Davdan11/Davdan11/vtol-quadplane/docs/essais_virtuels_mini.md

# Essais virtuels — Huard Mini

Généré par `calc/essais_virtuels.py`. Ce sont des calculs d'ingénieur classiques de pré-dimensionnement, faits sur les cotes réelles du modèle. Ils disent si la conception tient, avec quelle marge, et où sont les points faibles. Ils ne remplacent pas les essais au sol (test de charge de l'aile, voir plus bas) ni les premiers vols prudents.

Masse au décollage 2.21 kg, surface alaire 0.192 m², charge alaire 11.5 kg/m², décrochage 43 km/h, vitesse max réglée dans ArduPilot 90 km/h, vitesse de calcul en piqué 112 km/h.

## Résumé

✅ longeron principal Ø10 à 5.8 g (charge extrême) : 260 MPa pour 500 admissibles
✅ longeron extérieur Ø6 : 140 MPa pour 500
✅ aile en VTOL plein gaz : 104 MPa dans le longeron principal
✅ poutres en VTOL plein gaz : 36 MPa, flèche 0.4 mm
✅ atterrissage dur à 2 m/s : 196 MPa dans les poutres (21 g d'impact si les pattes s'écrasent de 10 mm)
✅ peau sous la pression de l'air : 3.4 MPa au pire panneau pour 25 MPa (flèche 0.46 mm)
✅ peau d'extrados comprimée par la flexion : elle n'ondule pas avant 7.1 g (charge limite 3.9 g)
✅ torsion à 112 km/h : peau 1.21 MPa, goupille 3 MPa, appui de la goupille dans le fuselage 1.9 MPa
✅ relais des longerons (recouvrement de 80 mm) : colle 0.16 MPa, appui dans le fourreau 0.7 MPa
✅ inversion des ailerons vers 903 km/h, divergence vers 498 km/h (il faut plus de 1,2 × 112 = 135 km/h)
✅ marge statique 14% (bien entre 5 et 20 %) : point neutre à 67 mm, centre de gravité à 45 mm
✅ volume d'empennage horizontal 0.41 (habituel 0,35 à 0,6)
✅ volume d'empennage vertical 0.024 (habituel 0,02 à 0,04)
✅ braquage de profondeur pour équilibrer : au plus 8° sur ±25° disponibles
✅ servos (±20° à 84 km/h, ±7° à 112 km/h) : aileron 0.19 kg·cm, profondeur 0.11 kg·cm, pour 2.2 kg·cm (8% ; à garder sous 50 %)
✅ résonance des poutres à 88 Hz (5300 tr/min) ; moteurs ≈ 10437 tr/min en stationnaire : on ne fait que la traverser en montant les gaz

✅ tient avec marge · ⚠️ à connaître (pas dangereux) · ❌ à corriger

## 1. Pression de l'air sur l'aile

Méthode des panneaux sur le profil NACA 4412 (Cp = 1 − (V/V∞)²). Dépression = Cp négatif, sur le dessus. Image : `docs/images/pression_aile_mini.png`.

| Cas | Vitesse | CL | Incidence du profil | Dépression max (bord d'attaque) |
|---|---:|---:|---:|---:|
| Croisière 72 km/h (1 g) | 72 km/h | 0.46 | -0.3° | 185 Pa (18.5 g/cm²) |
| Ressource à 84 km/h (3.9 g, portance max) | 84 km/h | 1.30 | 7.2° | 994 Pa (99.4 g/cm²) |
| Ressource à 112 km/h (3.9 g) | 112 km/h | 0.73 | 2.1° | 601 Pa (60.1 g/cm²) |

Peau de 0.6 mm entre deux âmes : le pire panneau fait 67 mm de large (Ressource à 112 km/h (3.9 g), segment 413–600 mm). Sous 550 Pa il fléchit de 0.46 mm et travaille à 3.40 MPa, pour environ 25 MPa de résistance : la peau ne se creuse pas visiblement.

## 2. Charges de vol

- Manœuvre : 3.8 g (catégorie normale). Rafale verticale de 7.6 m/s à 72 km/h : **3.9 g** (formule de Pratt ; un petit avion léger est très secoué par les rafales).
- Charge limite retenue **3.9 g**, charge extrême (1.5 ×) **5.8 g**.
- Vitesse de manœuvre (décroche avant de casser) : 84 km/h.

## 3. Flexion de l'aile

Répartition de portance de Schrenk. Image : `docs/images/flexion_aile_mini.png`.

| Endroit | Moment à charge extrême | Tube | Contrainte | Admissible |
|---|---:|---|---:|---:|
| Emplanture (y = 40 mm) | 15.0 N·m | Ø10 × 1 mm | 260 MPa | 500 MPa |
| Fin du longeron principal (y = 360 mm) | 2.4 N·m | Ø6 × 1 mm | 140 MPa | 500 MPa |
| Emplanture en VTOL plein gaz | 6.0 N·m | Ø10 × 1 mm | 104 MPa | 500 MPa |

Flèche en bout d'aile en vol normal (1 g) : **8 mm** (longerons seuls ; la peau raidit un peu).

**La peau suit la flexion.** Collée aux longerons par les âmes, la coque imprimée porte une partie de la flexion : l'extrados est comprimé. Une peau mince et large entre deux âmes ondule (voilement) quand la compression dépasse sa limite. Ce n'est pas une rupture (les tubes portent la charge), mais à répétition la peau peut fissurer. On veut donc que ça n'arrive pas avant la charge limite.

| Segment | Diagonales | Panneau le plus large | Part de la peau dans la raideur | Compression à 1 g | Limite d'ondulation | Ondule à partir de |
|---:|---:|---:|---:|---:|---:|---:|
| 1 | 12 | 23 mm | 57% | 1.18 MPa | 8.40 MPa | **7.1 g** |
| 2 | 8 | 37 mm | 53% | 0.46 MPa | 3.88 MPa | **8.5 g** |
| 3 | 5 | 67 mm | 87% | 0.17 MPa | 1.75 MPa | **10.2 g** |

Relais entre les longerons (recouvrement de 80 mm) : le tube extérieur pousse sur son fourreau avec ≈ 60 N à charge extrême, soit 0.7 MPa d'appui sur le PLA et 0.16 MPa dans la colle époxy (elle tient 10 à 20 MPa).

## 4. Torsion, goupille, inversion d'ailerons

- Couple de torsion à l'emplanture (112 km/h, aileron braqué, × 1.5) : 2.44 N·m.
- Cisaillement dans la peau : 1.21 MPa (≈ 12 admissibles).
- Goupille Ø4 : effort 38 N, cisaillement 3 MPa, appui dans le bossage du fuselage 1.9 MPa.
- Raideur en torsion de l'aile (coque seule) : GJ ≈ 29 N·m². Les ailerons s'inverseraient vers **903 km/h** et l'aile divergerait vers **498 km/h** : loin au-dessus de ce que l'avion peut faire.

## 5. Stabilité et équilibre

- Point neutre à **67 mm** du bord d'attaque (42% de corde), centre de gravité à 45 mm : **marge statique 14%**. Un avion se pilote bien entre 5 et 15 %.
- Volume d'empennage horizontal 0.41, vertical 0.024.
- Effet du fuselage pris en compte (Raymer) ; descente du flux de l'aile sur le stab dε/dα = 0.41.

| Vol en palier | Braquage de profondeur pour équilibrer | Assiette du fuselage |
|---|---:|---:|
| 56 km/h | -2.6° | +3.0° |
| 72 km/h | +0.6° | -0.6° |
| 90 km/h | +2.4° | -2.6° |
| Ressource 3.9 g à 84 km/h | -8.2° | |

(+ = bord de fuite de la profondeur vers le bas.) La profondeur garde de la réserve sur ses ±25°. ArduPilot règle le reste tout seul (TRIM_PITCH_DEG, autotune).

## 6. Servos et débattements

Comme la norme des avions légers : plein braquage (±20°) à la vitesse de manœuvre (84 km/h), un tiers du braquage à la vitesse de piqué (112 km/h). Servo qui tourne de ±45°.

| Gouverne | Moment de charnière | Bras du guignol (trou intérieur) | Trou du palonnier pour ±20° | Couple au servo | Servo |
|---|---:|---:|---:|---:|---:|
| Aileron (chacun) | 3.8 N·cm | 16 mm | **8 mm** de l'axe | 0.19 kg·cm | 8% de 2.2 kg·cm |
| Profondeur (les deux) | 2.3 N·cm | 11 mm | **5 mm** de l'axe | 0.11 kg·cm | 5% de 2.2 kg·cm |

Régler les fins de course dans ArduPilot (SERVOx_MIN / MAX) pour ±20° de gouverne, mesurés au rapporteur. Plus de débattement n'apporte rien à cet avion et charge les servos.

## 7. Poutres, vibrations, atterrissage

- Plein gaz en stationnaire (1.2 kg par moteur, × 1.5) : 36 MPa dans la poutre, flèche 0.4 mm au moteur.
- Fréquence propre d'une poutre avec son moteur : **88 Hz** (5300 tr/min). En stationnaire les moteurs tournent vers 10437 tr/min : on ne fait que traverser la résonance en montant les gaz. Équilibrer les hélices et activer le filtre anti-vibration d'ArduPilot (INS_HNTCH_*) après le premier vol.
- Atterrissage dur à 2 m/s (4 fois la vitesse normale) : si les pattes TPU s'écrasent de 10 mm, l'impact fait 21 g, 116 N par patte, 196 MPa dans les poutres.

## Ce qu'il faut vérifier en vrai

1. **Test de charge de l'aile au sol** (le plus important) : aile montée sur le fuselage, posée à l'envers sur deux tréteaux sous le fuselage, répartir des sacs de sable sur l'intrados. 3.9 g, c'est 8.6 kg en tout, dont 60 % sur la moitié intérieure de chaque aile. Monter par paliers ; l'aile doit revenir droite. Ne pas aller jusqu'à la charge extrême.
2. **Les servos** : avec l'avion branché, pousser une gouverne au doigt : elle ne doit pas bouger, et le servo ne doit pas grogner au neutre.
3. **Le centrage** : soulever l'avion du bout des doigts sous l'aile au point de centrage (45 mm du bord d'attaque) : il doit rester à plat ou piquer très légèrement du nez.
4. **Les vibrations** : premier vol stationnaire, puis lire le log (VIBE) dans Mission Planner.

## Hypothèses

- PLA imprimé : module 3000 MPa, résistance 25 MPa, cisaillement 12 MPa (valeurs prudentes, non mesurées).
- Tubes carbone roulés : module 100 GPa, 500 MPa admissibles en flexion (les tubes du commerce tiennent 600 à 1000 MPa) ; épaisseur 1 mm.
- Servo 2.2 kg·cm à 4,8 V (fiche technique), à garder sous 50 % en continu. Moment de charnière : coefficients habituels d'une gouverne simple ; peau de gouverne étanche (ruban).
- Méthode des panneaux sans viscosité : elle surestime un peu la dépression (côté sûr).
- Poussée max d'un moteur VTOL : 1.2 kg (même valeur que le bilan).
