Davdan11/Davdan11/vtol-quadplane/cad/out/rendus/vue_cote.png

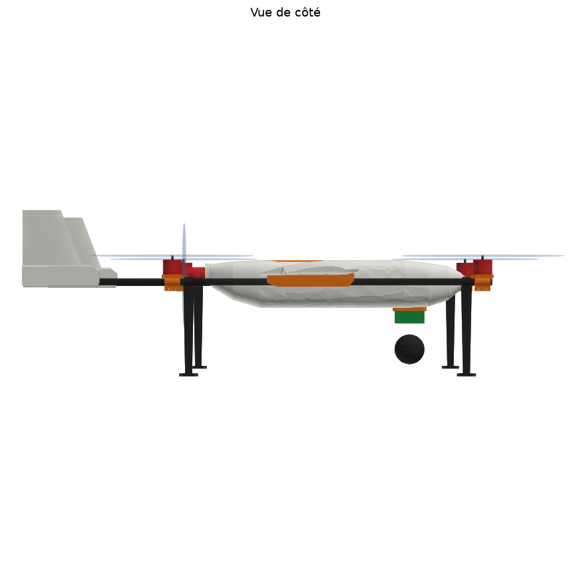
vtol-quadplane/cad/out/rendus/vue_cote.png
