Davdan11/Davdan11/vtol-quadplane/cad/out/rendus/vue_face.png

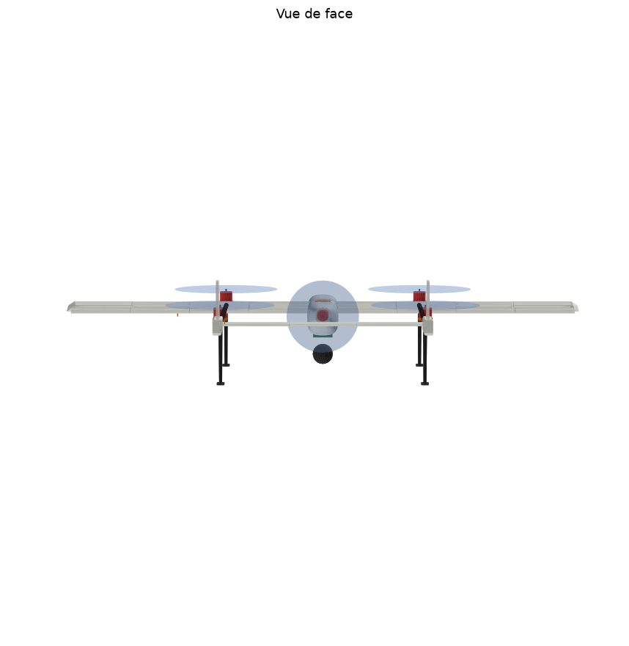
vtol-quadplane/cad/out/rendus/vue_face.png
