Davdan11/Davdan11/vtol-quadplane/cad/out_mini/rendus/vue_dessus.png

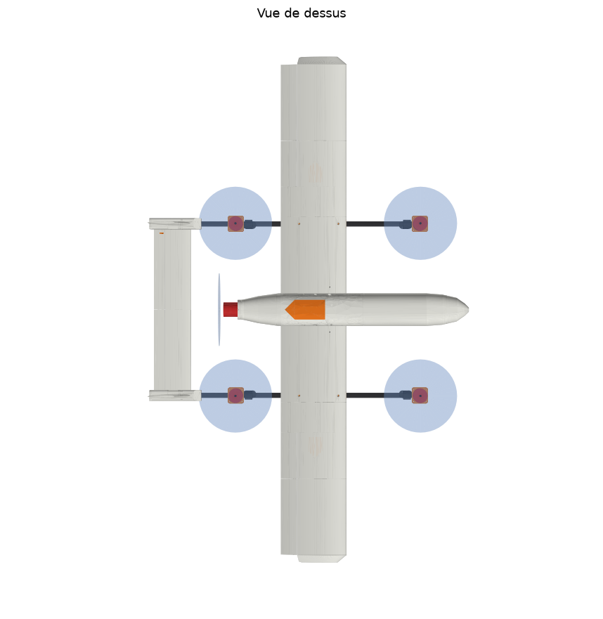
vtol-quadplane/cad/out_mini/rendus/vue_dessus.png
