Davdan11/Davdan11/vtol-quadplane/docs/images/batterie_dfr.png

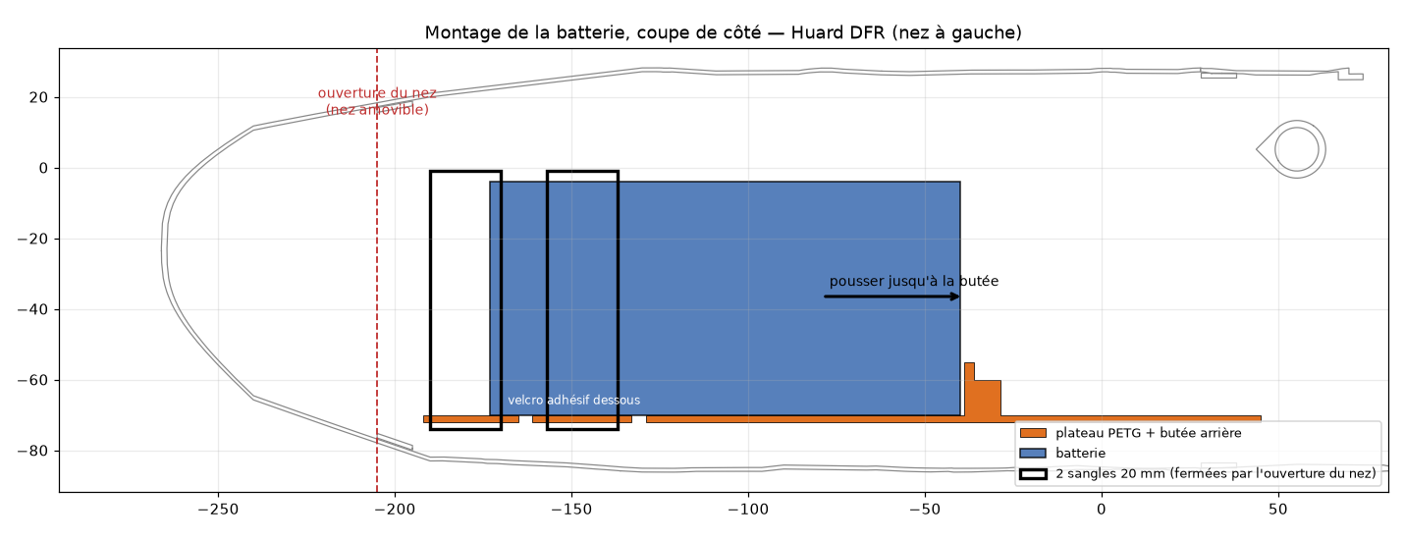
vtol-quadplane/docs/images/batterie_dfr.png
