Davdan11/Davdan11/vtol-quadplane/docs/images/batterie_mini.png

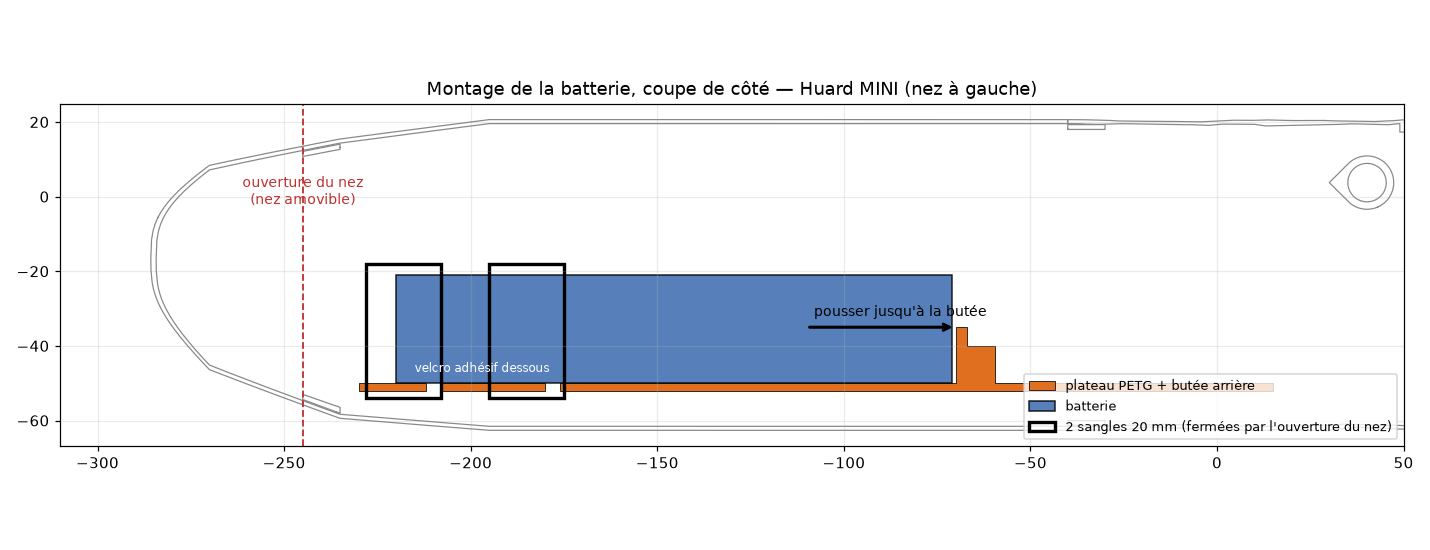
vtol-quadplane/docs/images/batterie_mini.png
