Davdan11/Davdan11/vtol-quadplane/docs/images/coupe_servo_aileron_dfr.png

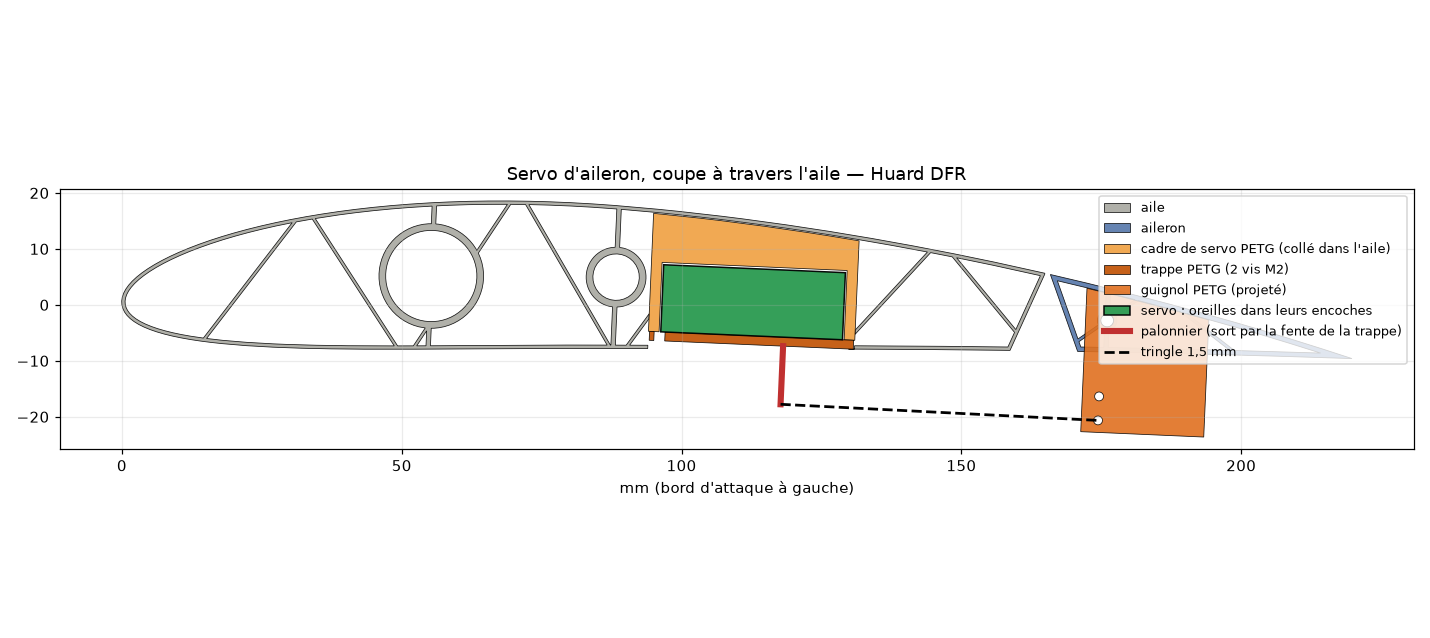
vtol-quadplane/docs/images/coupe_servo_aileron_dfr.png
