Davdan11/Davdan11/vtol-quadplane/docs/images/flexion_aile.png

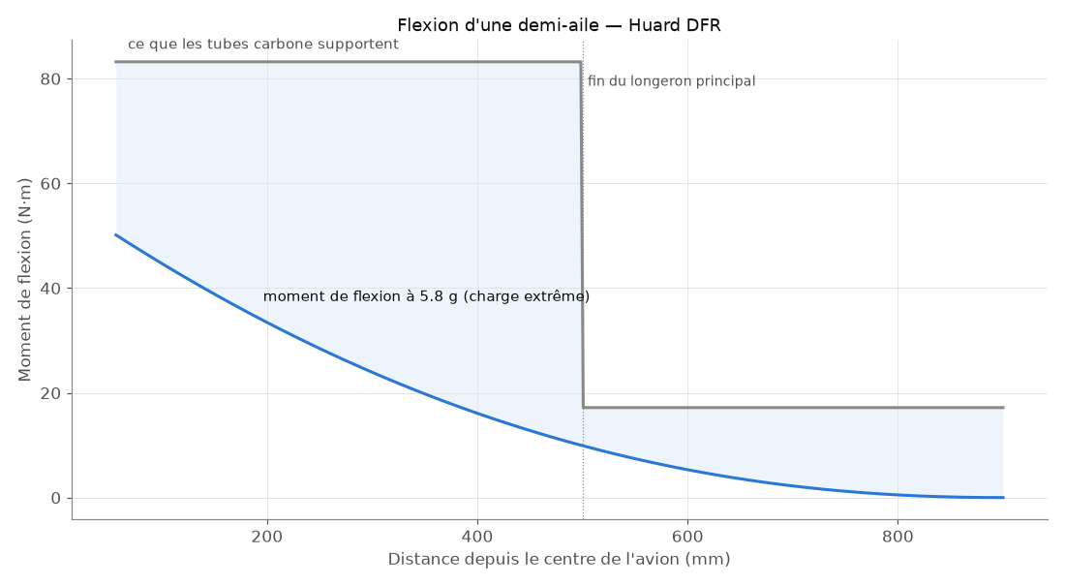
vtol-quadplane/docs/images/flexion_aile.png
