Davdan11/Davdan11/vtol-quadplane/docs/images/flexion_aile_mini.png

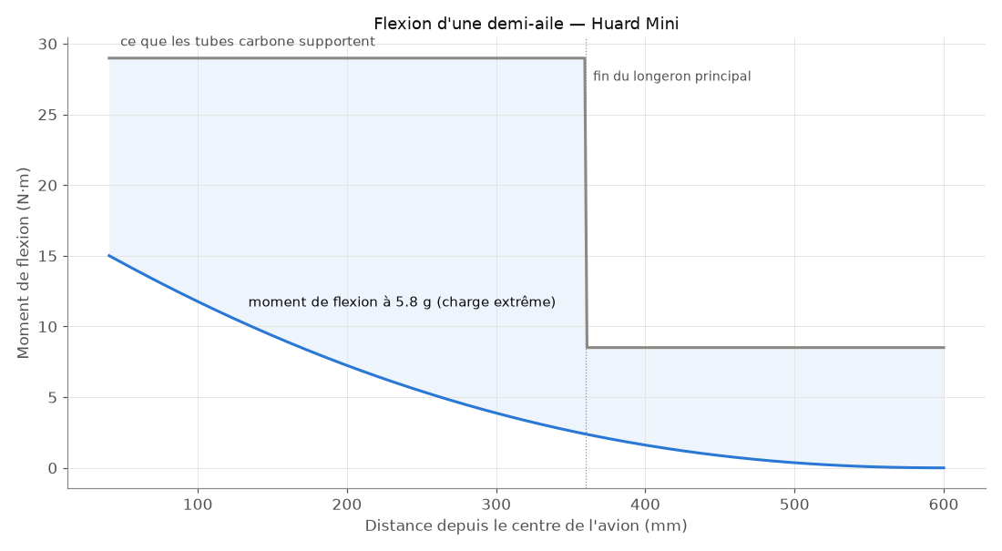
vtol-quadplane/docs/images/flexion_aile_mini.png
