Davdan11/Davdan11/vtol-quadplane/docs/images/gps_dfr.png

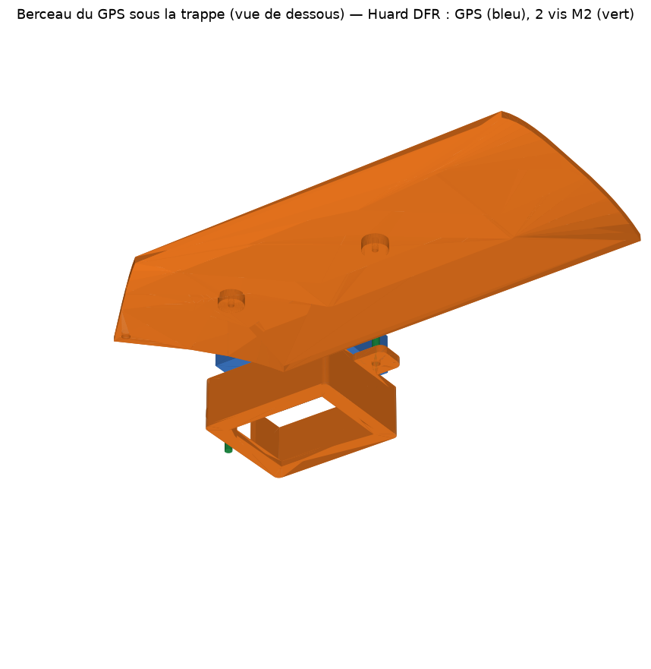
vtol-quadplane/docs/images/gps_dfr.png
