Davdan11/Davdan11/vtol-quadplane/docs/images/gps_mini.png

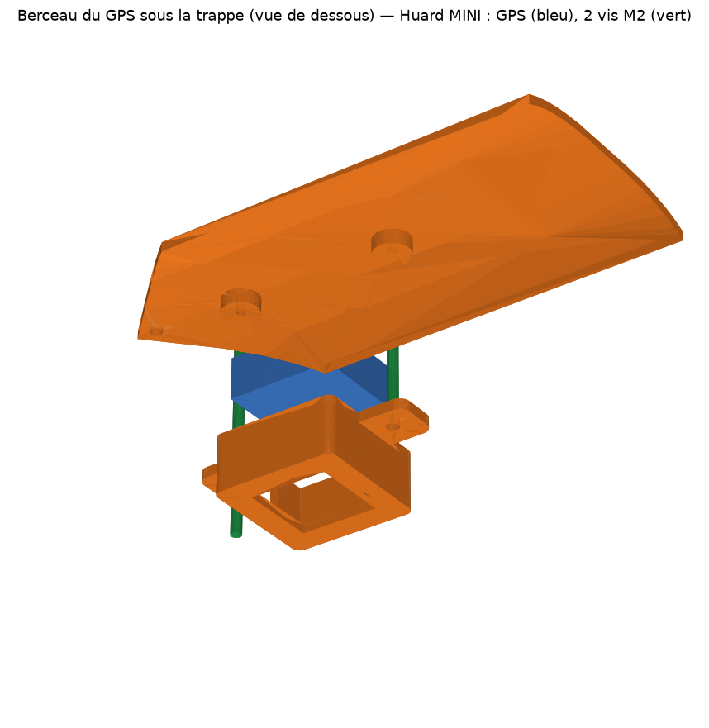
vtol-quadplane/docs/images/gps_mini.png
