Davdan11/Davdan11/vtol-quadplane/docs/images/pression_aile.png

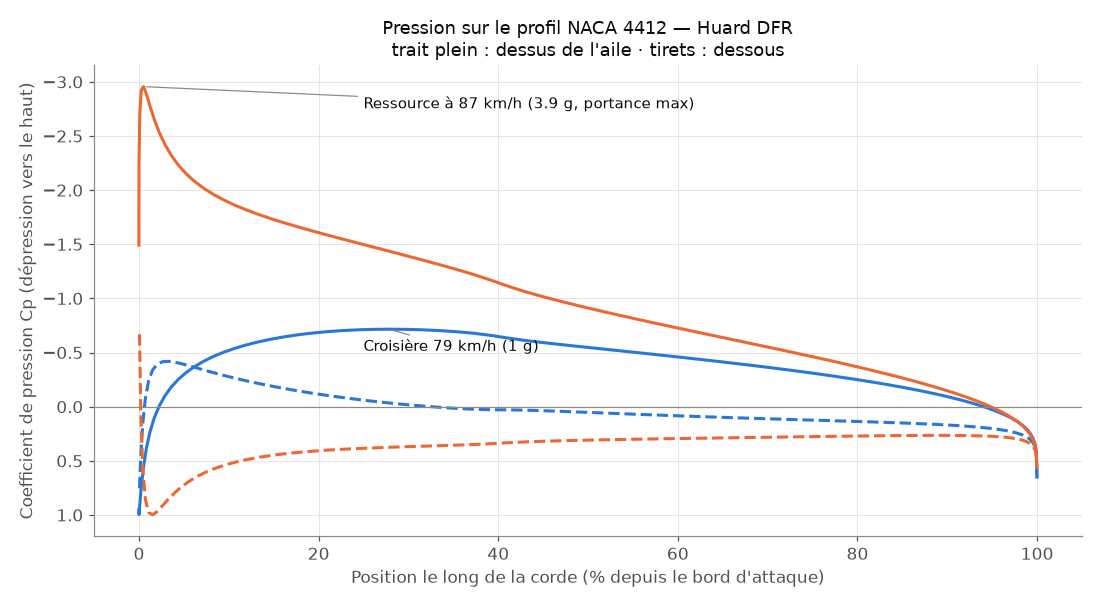
vtol-quadplane/docs/images/pression_aile.png
