Davdan11/Davdan11/vtol-quadplane/docs/images/pylone_dfr.png

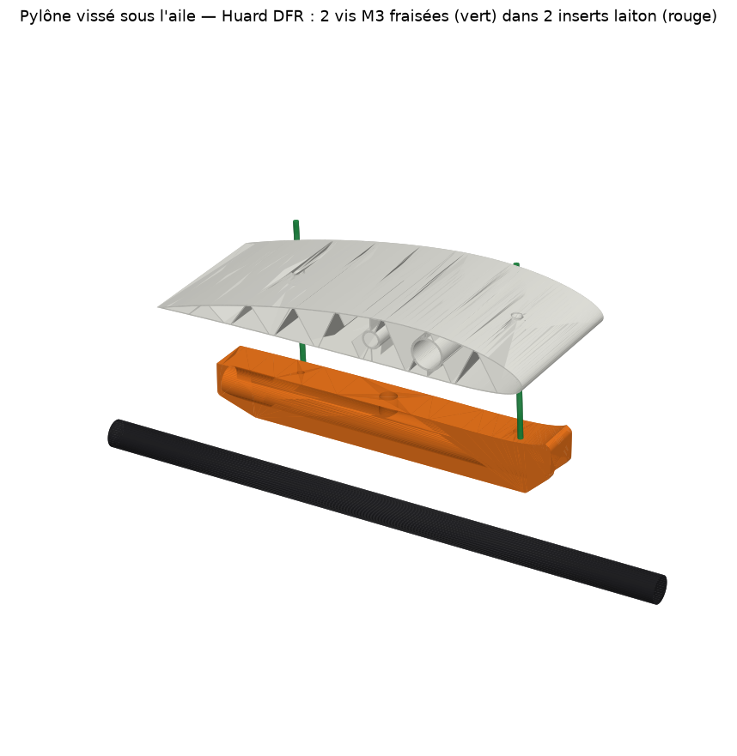
vtol-quadplane/docs/images/pylone_dfr.png
