Davdan11/Davdan11/vtol-quadplane/docs/images/pylone_mini.png

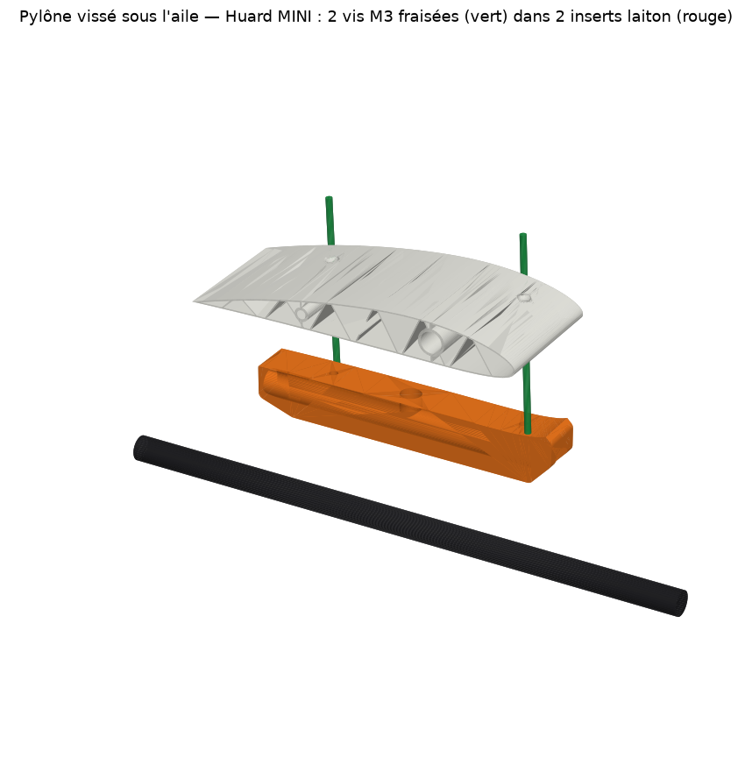
vtol-quadplane/docs/images/pylone_mini.png
