Davdan11/Davdan11/vtol-quadplane/docs/images/support_moteur_dfr.png

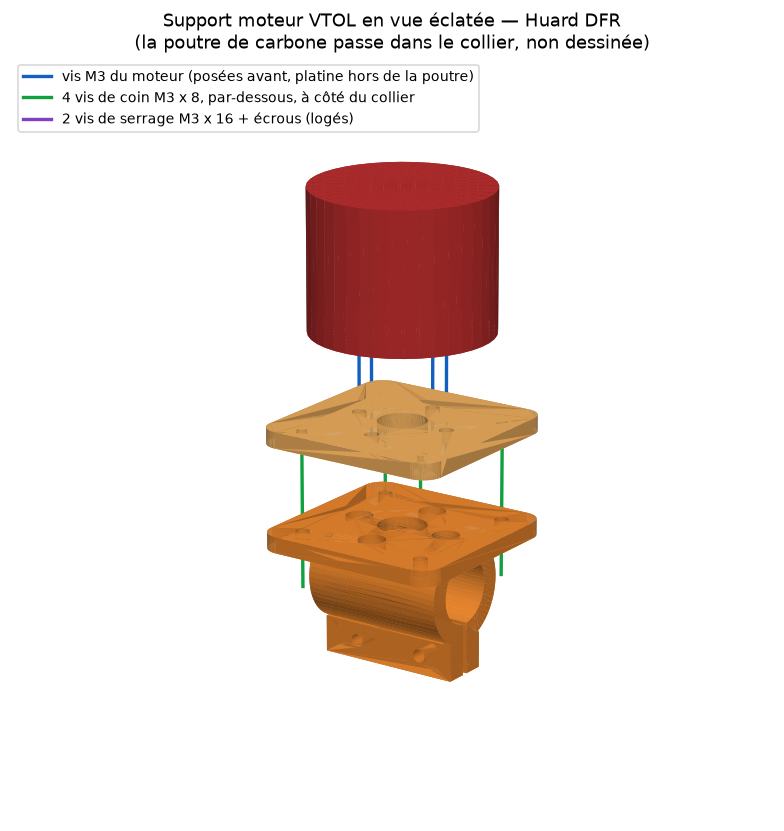
vtol-quadplane/docs/images/support_moteur_dfr.png
