Davdan11/Davdan11/vtol-quadplane/docs/images/trappe_acces_mini.png

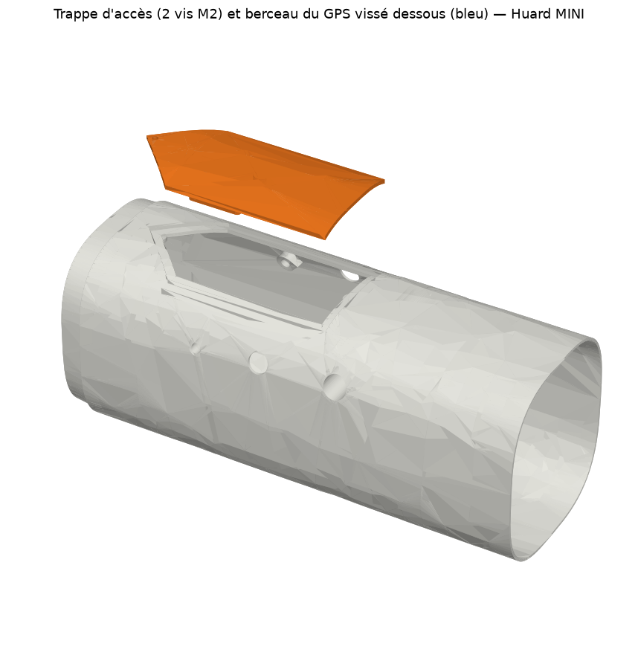
vtol-quadplane/docs/images/trappe_acces_mini.png
