Davdan11/Davdan11/vtol-quadplane/cad/out/masses.csv

piece | quantite | materiau | dimensions_impression_mm | masse_g | masse_totale_g | x_cg_mm
aile_segment_1_droit | 1 | PLA Aero | 220x28x223 | 77.0 | 77.0 | 99
aile_segment_1_gauche | 1 | PLA Aero | 220x28x223 | 77.0 | 77.0 | 99
aile_segment_2_droit | 1 | PLA Aero | 220x28x211 | 70.8 | 70.8 | 97
aile_segment_2_gauche | 1 | PLA Aero | 220x28x211 | 70.8 | 70.8 | 97
aile_segment_3_droit | 1 | PLA Aero | 165x27x211 | 56.0 | 56.0 | 79
aile_segment_3_gauche | 1 | PLA Aero | 165x27x211 | 56.0 | 56.0 | 79
aile_segment_4_droit | 1 | PLA Aero | 165x27x211 | 44.6 | 44.6 | 84
aile_segment_4_gauche | 1 | PLA Aero | 165x27x211 | 44.6 | 44.6 | 84
aileron_1_droit | 1 | PLA Aero | 54x15x211 | 15.4 | 15.4 | 188
aileron_1_gauche | 1 | PLA Aero | 54x15x211 | 15.4 | 15.4 | 188
aileron_2_droit | 1 | PLA Aero | 54x15x210 | 15.4 | 15.4 | 188
aileron_2_gauche | 1 | PLA Aero | 54x15x210 | 15.4 | 15.4 | 188
saumon_droit | 1 | PLA Aero | 165x27x19 | 9.2 | 9.2 | 82
saumon_gauche | 1 | PLA Aero | 165x27x19 | 9.2 | 9.2 | 82
pylone_poutre_droit | 1 | PETG | 32x24x204 | 54.8 | 54.8 | 100
pylone_poutre_gauche | 1 | PETG | 32x24x204 | 54.8 | 54.8 | 100
fuselage_nez | 1 | PLA Aero | 104x100x91 | 17.5 | 17.5 | -229
fuselage_avant | 1 | PLA Aero | 120x112x243 | 63.7 | 63.7 | -78
fuselage_milieu | 1 | PLA Aero | 120x112x238 | 69.5 | 69.5 | 137
fuselage_queue | 1 | PLA Aero | 108x103x105 | 21.5 | 21.5 | 306
cloison_moteur | 1 | PETG | 50x52x5 | 12.5 | 12.5 | 357
plateau_electronique | 1 | PETG | 237x80x17 | 51.3 | 51.3 | -69
plateau_compagnon | 1 | PETG | 145x70x8 | 26.0 | 26.0 | 164
support_moteur | 4 | PETG | 49x49x34 | 24.8 | 99.2 | 62
platine_moteur | 4 | PETG | 49x49x4 | 11.1 | 44.3 | 62
patte_atterrissage | 4 | TPU 95A | 44x26x234 | 44.3 | 177.4 | 62
bloc_queue_droit | 1 | PLA Aero | 180x30x182 | 65.7 | 65.7 | 700
bloc_queue_gauche | 1 | PLA Aero | 180x30x182 | 65.7 | 65.7 | 700
trappe_acces | 1 | PETG | 8x67x146 | 16.9 | 16.9 | 135
support_gps | 1 | PETG | 56x32x15 | 4.3 | 4.3 | 152
guignol_aileron | 2 | PETG | 23x27x2 | 1.3 | 2.6 | 183
cadre_servo_aile_droit | 1 | PETG | 37x34x21 | 11.6 | 11.6 | 112
cadre_servo_aile_gauche | 1 | PETG | 37x34x21 | 11.6 | 11.6 | 112
trappe_servo_aile_droit | 1 | PETG | 37x52x2 | 3.0 | 3.0 | 112
trappe_servo_aile_gauche | 1 | PETG | 37x52x2 | 3.0 | 3.0 | 112
guignol_profondeur | 1 | PETG | 11x19x2 | 0.5 | 0.5 | 727
support_nacelle | 1 | PETG | 83x61x15 | 36.4 | 36.4 | -147
entretoise_plateau_avant | 1 | PETG | 10x10x12 | 1.1 | 1.1 | -177
entretoise_plateau_arriere | 1 | PETG | 10x10x15 | 1.3 | 1.3 | -113
stab_segment_1 | 1 | PLA Aero | 77x10x230 | 24.3 | 24.3 | 679
profondeur_1 | 1 | PLA Aero | 32x6x229 | 8.2 | 8.2 | 731
stab_segment_2 | 1 | PLA Aero | 77x10x230 | 24.3 | 24.3 | 679
profondeur_2 | 1 | PLA Aero | 32x6x229 | 8.2 | 8.2 | 731
stab_segment_3 | 1 | PLA Aero | 77x10x230 | 24.3 | 24.3 | 679
profondeur_3 | 1 | PLA Aero | 32x6x229 | 8.1 | 8.1 | 731
TOTAL pièces imprimées |  |  |  |  | 1590 | 165
