Davdan11/Davdan11/vtol-quadplane/cad/out/essais/4_platine_moteur.stl

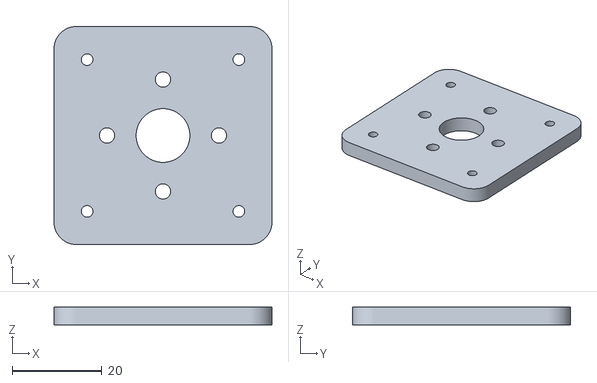
[picture p24: CAD file, 2026-10-05]
vtol-quadplane/cad/out/essais/4_platine_moteur.stl
48.7 x 48.7 x 4.00
