Davdan11/Davdan11/vtol-quadplane/cad/out/step/aileron_1_droit.step

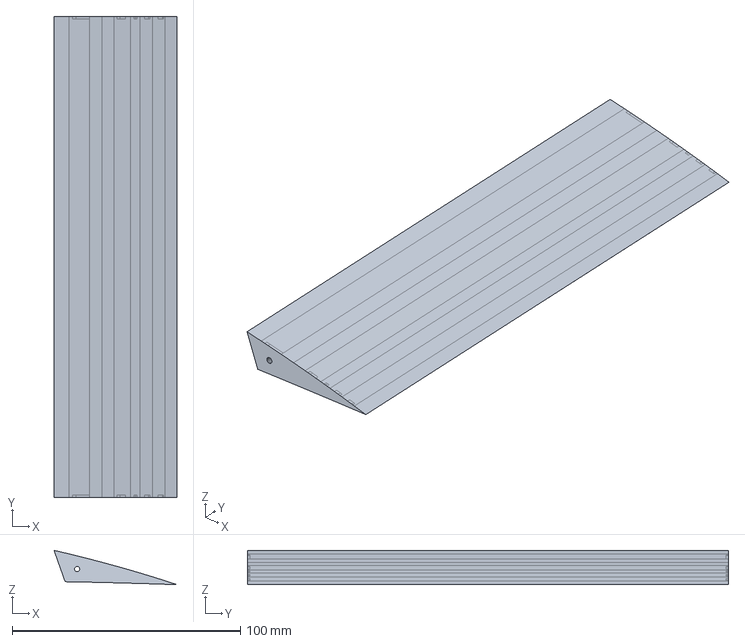
[picture p25: CAD file, 2026-10-05]
vtol-quadplane/cad/out/step/aileron_1_droit.step
53.9 x 210.8 x 15.0 mm
