Davdan11/Davdan11/vtol-quadplane/cad/out_mini/essais/4_platine_moteur.stl

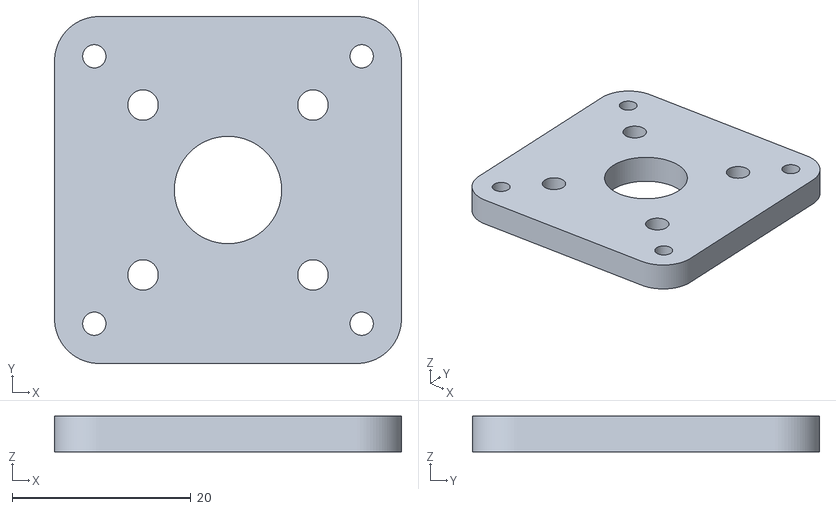
[picture p26: CAD file, 2026-10-05]
vtol-quadplane/cad/out_mini/essais/4_platine_moteur.stl
38.8 x 38.8 x 4.00
