Davdan11/Davdan11/vtol-quadplane/cad/out_mini/step/pylone_poutre_gauche.step

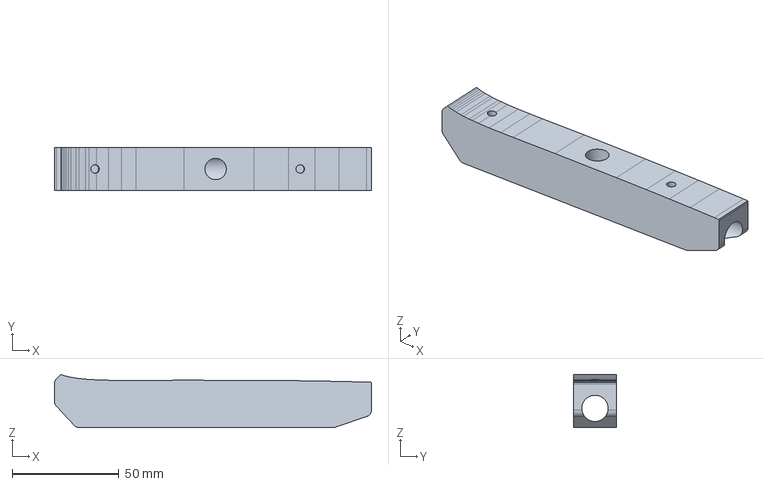
[picture p27: CAD file, 2026-10-05]
vtol-quadplane/cad/out_mini/step/pylone_poutre_gauche.step
148.4 x 20.0 x 24.9 mm
