Davdan11/Davdan11/vtol-quadplane/cad/out/essais/3_jonction_cote_milieu.stl

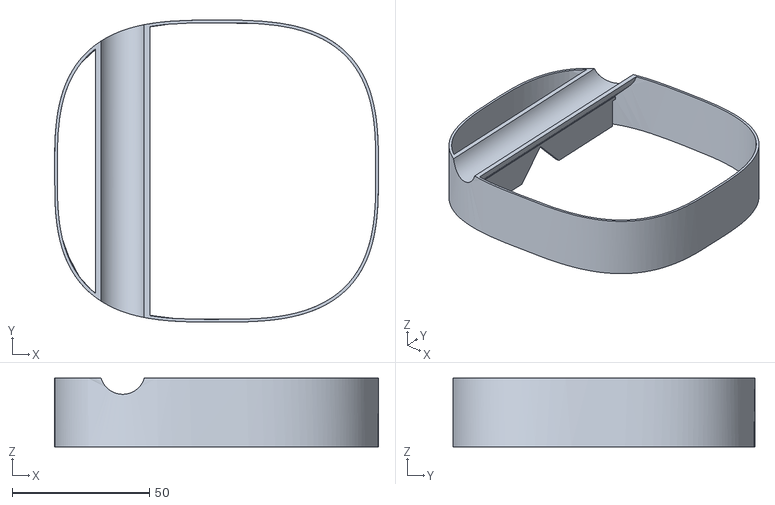
[picture p28: CAD file, 2026-10-05]
vtol-quadplane/cad/out/essais/3_jonction_cote_milieu.stl
118.0 x 109.9 x 25.0
