Davdan11/Davdan11/vtol-quadplane/cad/out/step/aile_segment_2_droit.step

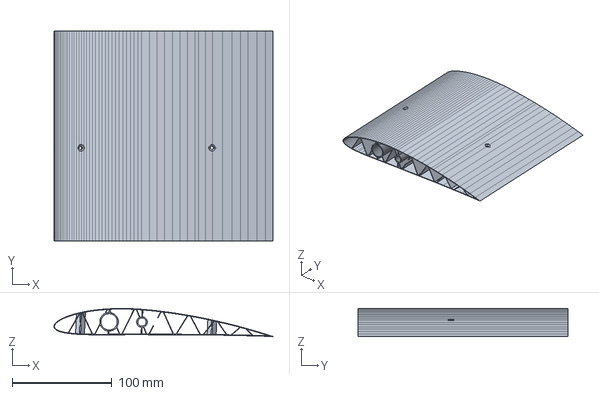
[picture p29: CAD file, 2026-10-05]
vtol-quadplane/cad/out/step/aile_segment_2_droit.step
219.8 x 211.2 x 28.2 mm
