Davdan11/Davdan11/vtol-quadplane/cad/out_mini/essais/2_tranche_aile.stl

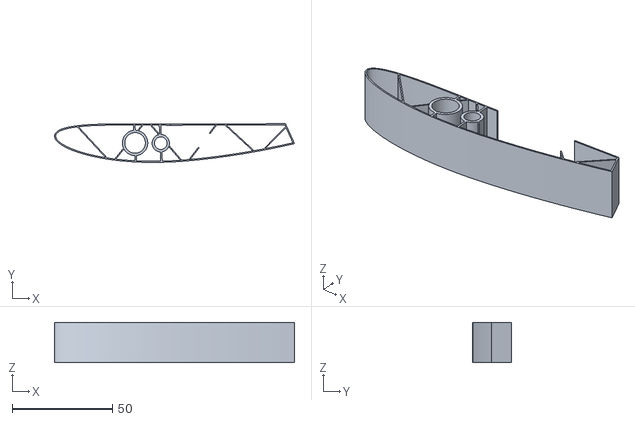
[picture p30: CAD file, 2026-10-05]
vtol-quadplane/cad/out_mini/essais/2_tranche_aile.stl
119.8 x 19.4 x 20.0
