Davdan11/Davdan11/vtol-quadplane/cad/out/essais/2_tranche_aile.stl

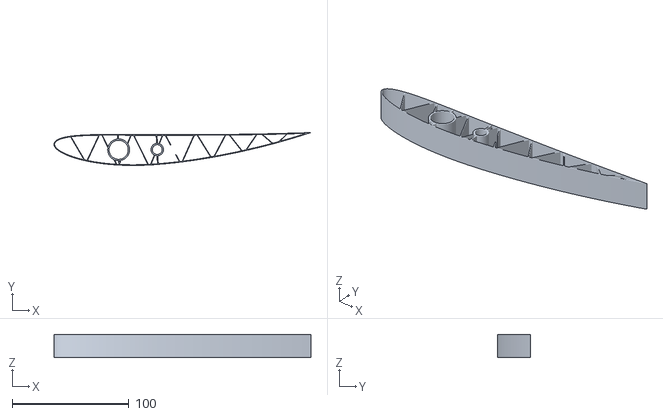
[picture p31: CAD file, 2026-10-05]
vtol-quadplane/cad/out/essais/2_tranche_aile.stl
219.8 x 28.2 x 20.0
