Davdan11/Davdan11/vtol-quadplane/cad/out/step/plateau_compagnon.step

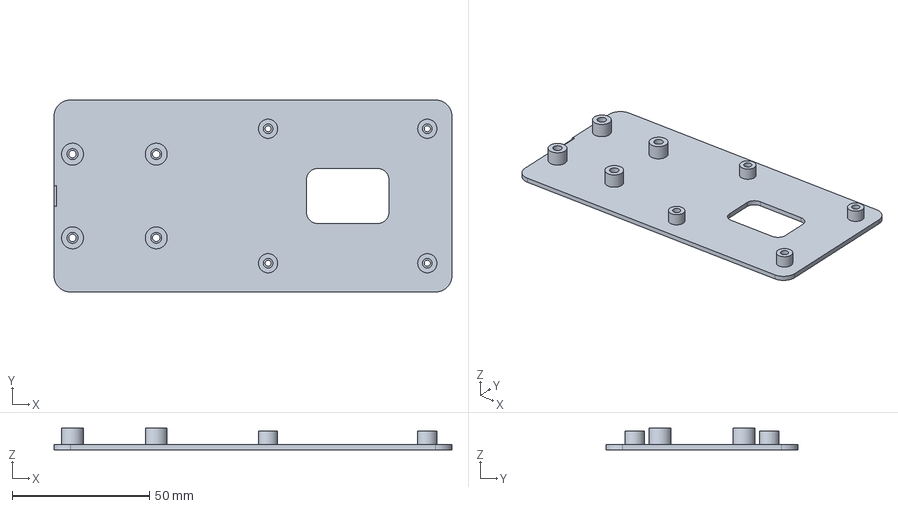
[picture p32: CAD file, 2026-10-05]
vtol-quadplane/cad/out/step/plateau_compagnon.step
145.0 x 70.0 x 8.00 mm
