Davdan11/Davdan11/vtol-quadplane/cad/out_mini/essais/5_trappe_servo_aile.stl

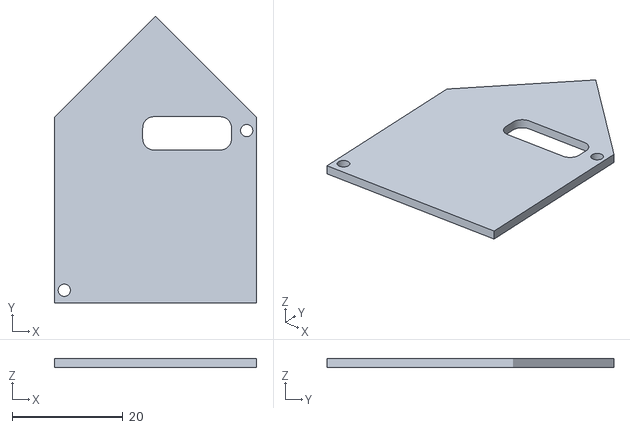
[picture p33: CAD file, 2026-10-05]
vtol-quadplane/cad/out_mini/essais/5_trappe_servo_aile.stl
36.5 x 51.8 x 1.60
