Davdan11/Davdan11/vtol-quadplane/cad/out_mini/step/cloison_moteur.step

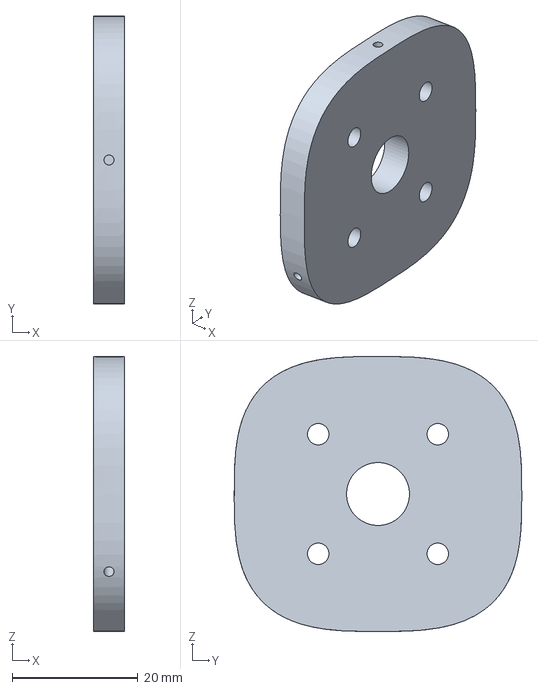
[picture p34: CAD file, 2026-10-05]
vtol-quadplane/cad/out_mini/step/cloison_moteur.step
5.00 x 45.7 x 43.7 mm
