Davdan11/Davdan11/vtol-quadplane/cad/out/essais/1_jauge_tubes.stl

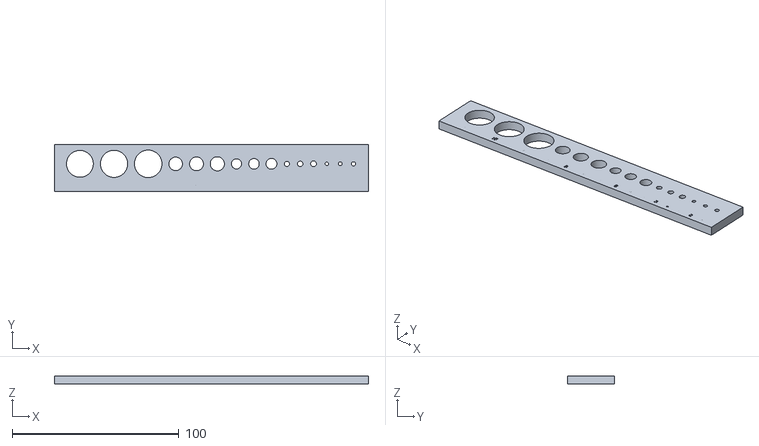
[picture p35: CAD file, 2026-10-05]
vtol-quadplane/cad/out/essais/1_jauge_tubes.stl
188.5 x 28.0 x 5.00
