Davdan11/Davdan11/vtol-quadplane/cad/out/step/stab_segment_1.step

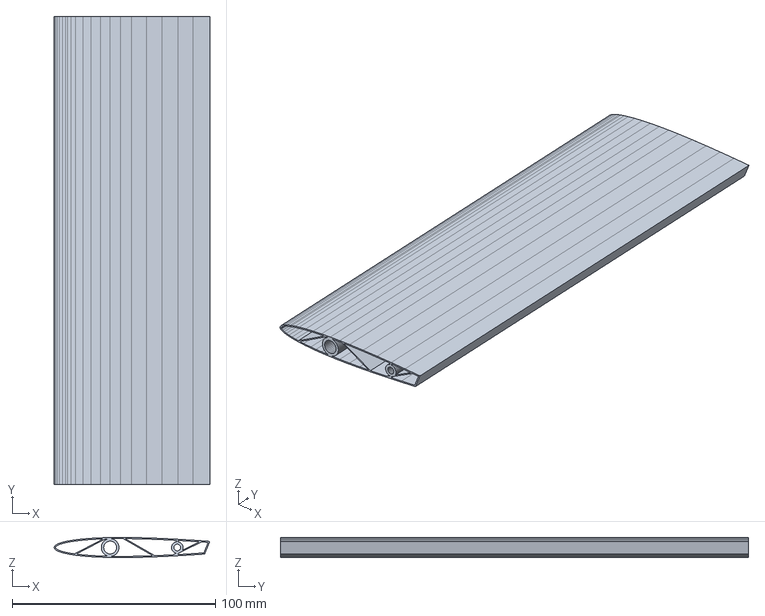
[picture p36: CAD file, 2026-10-05]
vtol-quadplane/cad/out/step/stab_segment_1.step
76.5 x 230.0 x 9.89 mm
