Davdan11/Davdan11/vtol-quadplane/cad/out_mini/essais/3_jonction_cote_avant.stl

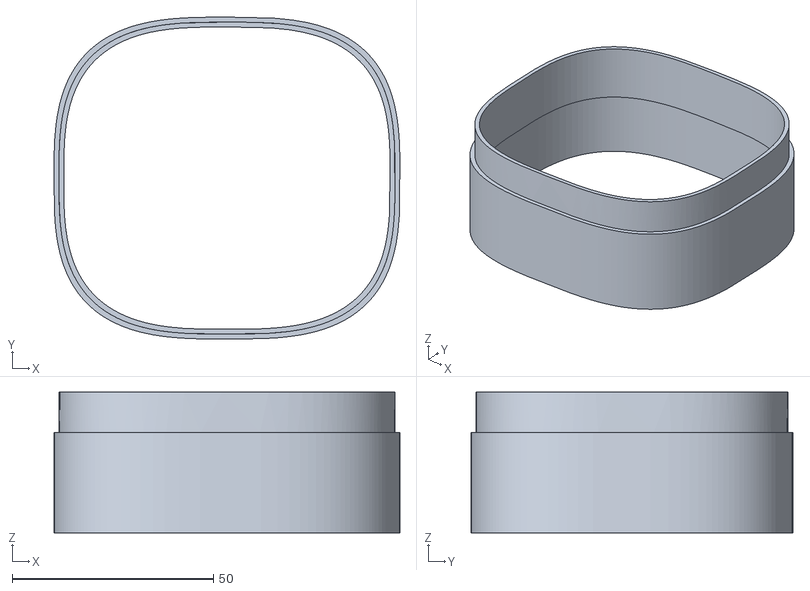
[picture p37: CAD file, 2026-10-05]
vtol-quadplane/cad/out_mini/essais/3_jonction_cote_avant.stl
85.9 x 80.0 x 35.0
