Davdan11/Davdan11/vtol-quadplane/cad/out_mini/step/aile_segment_2_gauche.step

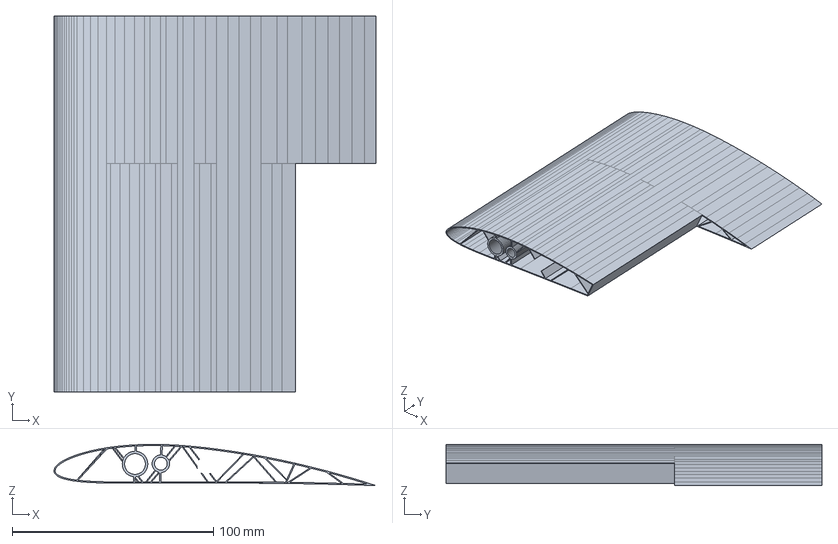
[picture p38: CAD file, 2026-10-05]
vtol-quadplane/cad/out_mini/step/aile_segment_2_gauche.step
159.9 x 186.7 x 20.5 mm
