Davdan11/Davdan11/vtol-quadplane/cad/out/step/aile_segment_1_gauche.step

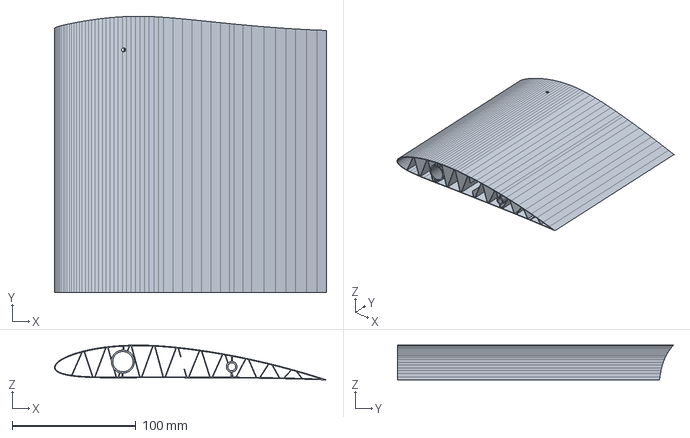
[picture p39: CAD file, 2026-10-05]
vtol-quadplane/cad/out/step/aile_segment_1_gauche.step
219.8 x 223.3 x 28.2 mm
