Davdan11/Davdan11/vtol-quadplane/cad/out_mini/essais/3_jonction_cote_milieu.stl

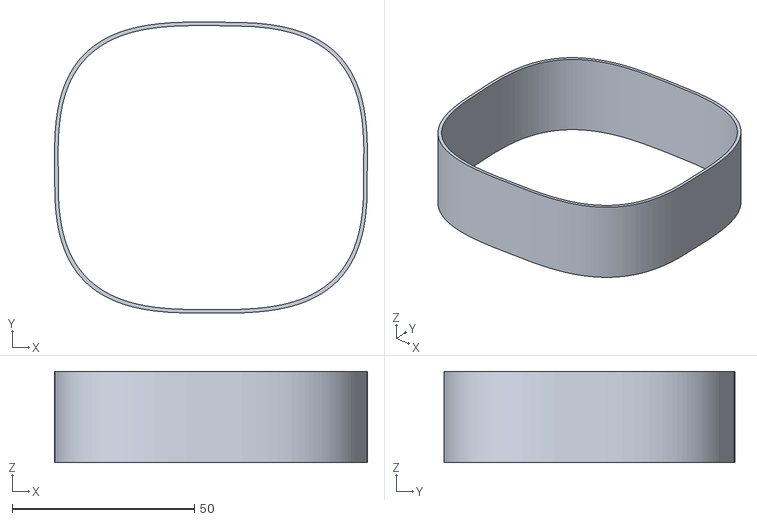
[picture p40: CAD file, 2026-10-05]
vtol-quadplane/cad/out_mini/essais/3_jonction_cote_milieu.stl
85.9 x 80.0 x 25.0
