Davdan11/Davdan11/vtol-quadplane/cad/out_mini/step/trappe_acces.step

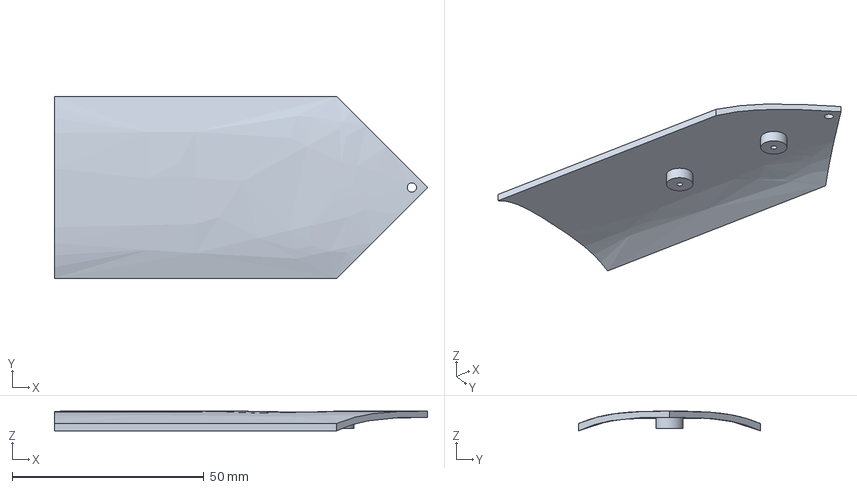
[picture p41: CAD file, 2026-10-05]
vtol-quadplane/cad/out_mini/step/trappe_acces.step
97.3 x 47.4 x 5.14 mm
