Davdan11/Davdan11/vtol-quadplane/cad/out/essais/5_cadre_servo_aile.stl

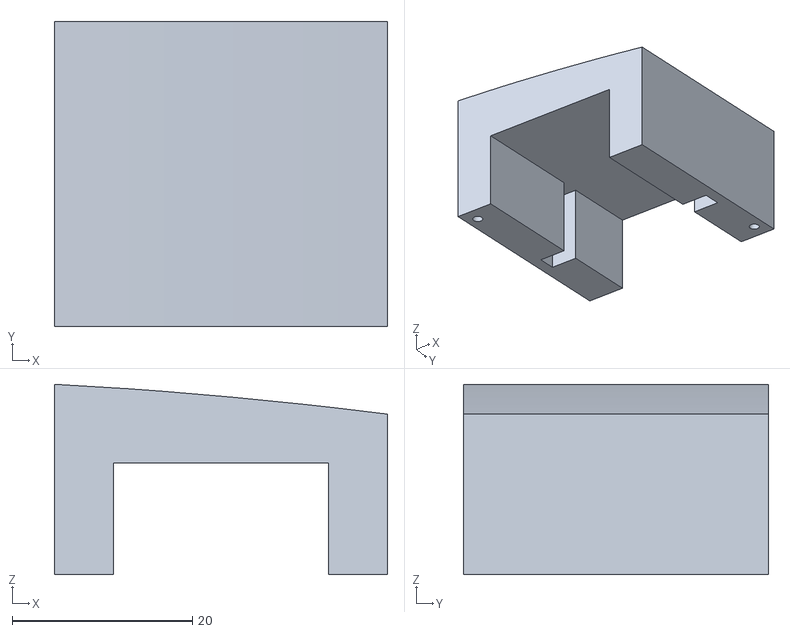
[picture p42: CAD file, 2026-10-05]
vtol-quadplane/cad/out/essais/5_cadre_servo_aile.stl
36.9 x 33.8 x 21.1
