Davdan11/Davdan11/vtol-quadplane/cad/out/step/support_gps.step

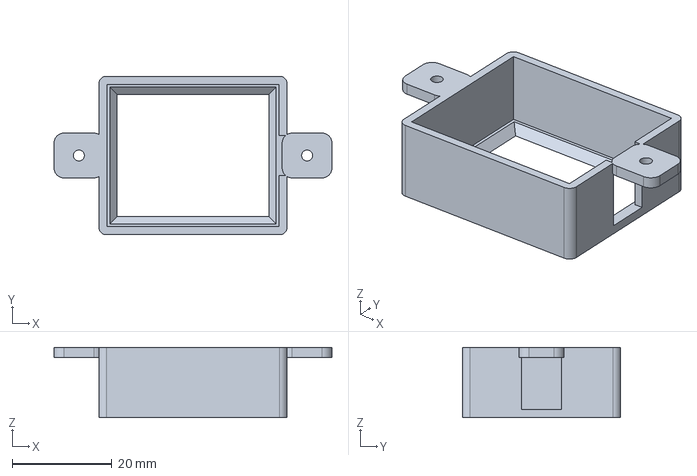
[picture p43: CAD file, 2026-10-05]
vtol-quadplane/cad/out/step/support_gps.step
55.8 x 31.8 x 14.1 mm
