Davdan11/Davdan11/vtol-quadplane/cad/out_mini/essais/1_jauge_tubes.stl

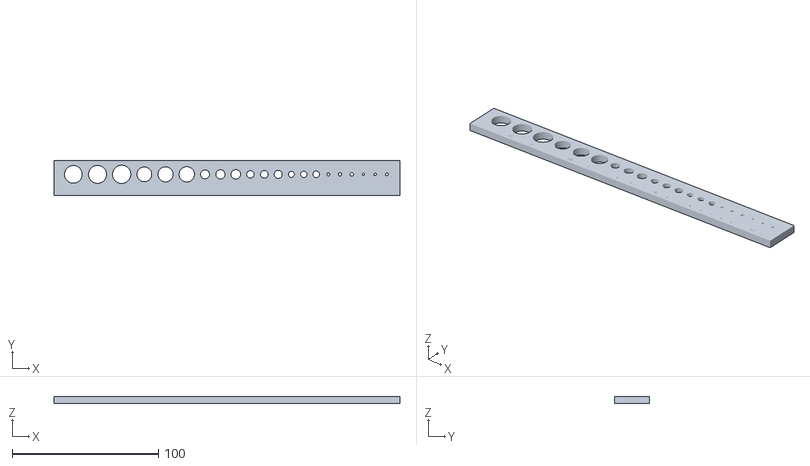
[picture p44: CAD file, 2026-10-05]
vtol-quadplane/cad/out_mini/essais/1_jauge_tubes.stl
236.5 x 24.0 x 5.00
