Davdan11/Davdan11/vtol-quadplane/cad/out_mini/step/aileron_1_droit.step

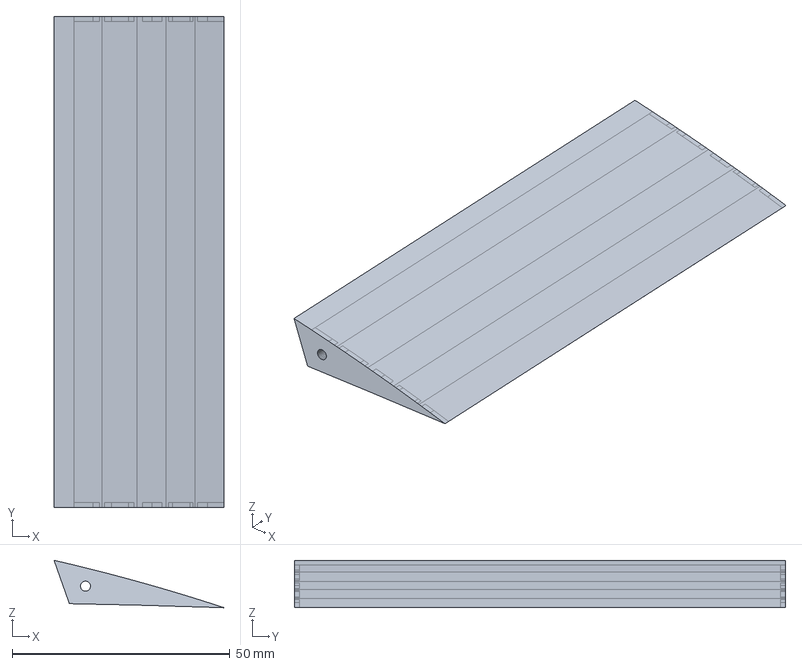
[picture p45: CAD file, 2026-10-05]
vtol-quadplane/cad/out_mini/step/aileron_1_droit.step
39.0 x 112.8 x 10.9 mm
