Davdan11/Davdan11/vtol-quadplane/cad/out/essais/6_guignol_aileron.stl

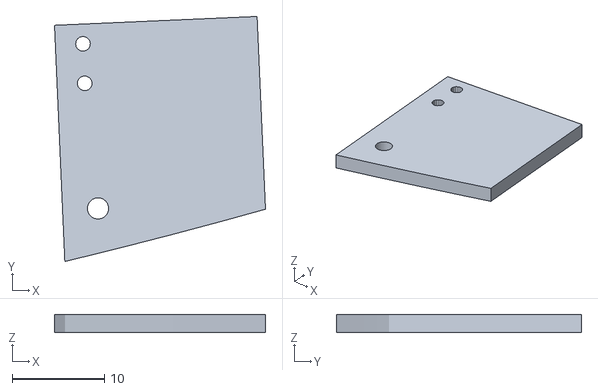
[picture p46: CAD file, 2026-10-05]
vtol-quadplane/cad/out/essais/6_guignol_aileron.stl
22.9 x 26.6 x 2.00
