Davdan11/Davdan11/vtol-quadplane/cad/out/step/saumon_droit.step

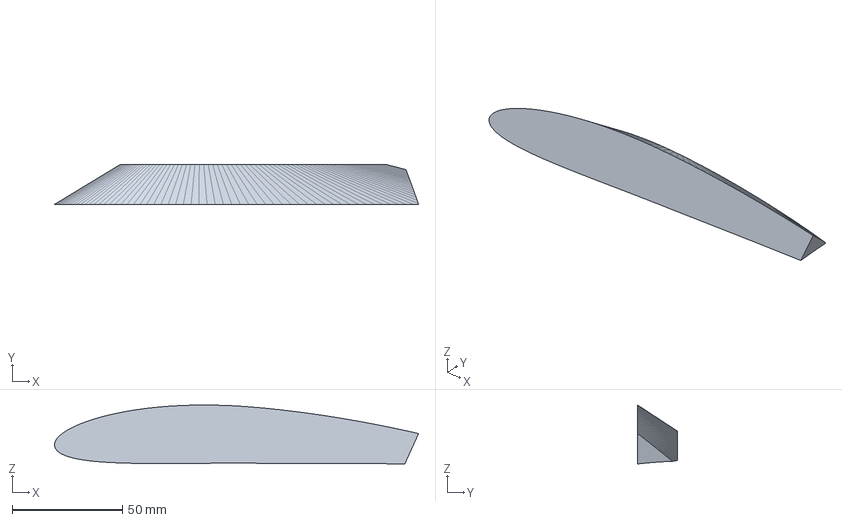
[picture p47: CAD file, 2026-10-05]
vtol-quadplane/cad/out/step/saumon_droit.step
164.9 x 18.0 x 26.7 mm
