Davdan11/Davdan11/vtol-quadplane/cad/out_mini/essais/6_guignol_aileron.stl

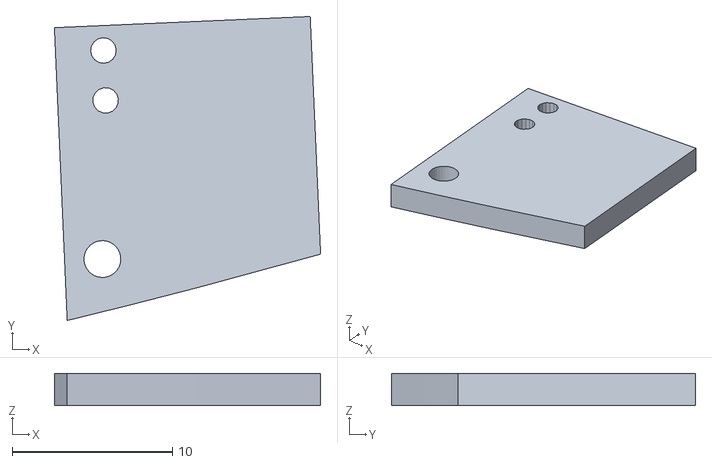
[picture p48: CAD file, 2026-10-05]
vtol-quadplane/cad/out_mini/essais/6_guignol_aileron.stl
16.6 x 19.0 x 2.00
