Davdan11/Davdan11/vtol-quadplane/cad/out_mini/step/aileron_2_droit.step

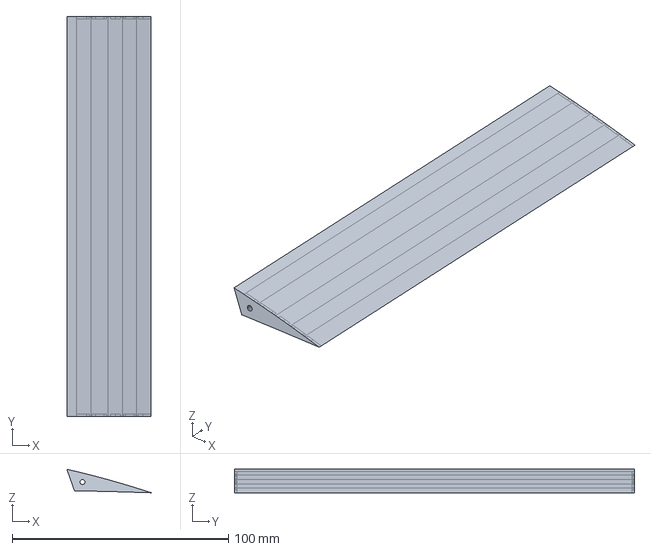
[picture p49: CAD file, 2026-10-05]
vtol-quadplane/cad/out_mini/step/aileron_2_droit.step
39.0 x 185.2 x 10.9 mm
