Davdan11/Davdan11/vtol-quadplane/cad/out/essais/3_jonction_cote_avant.stl

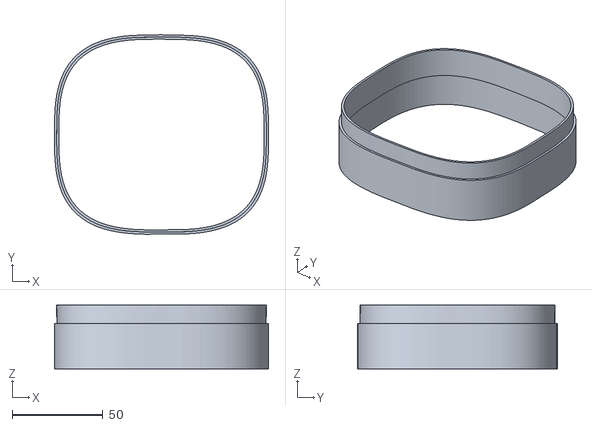
[picture p50: CAD file, 2026-10-05]
vtol-quadplane/cad/out/essais/3_jonction_cote_avant.stl
117.9 x 109.9 x 35.0
