Davdan11/Davdan11/vtol-quadplane/cad/out/step/profondeur_3.step

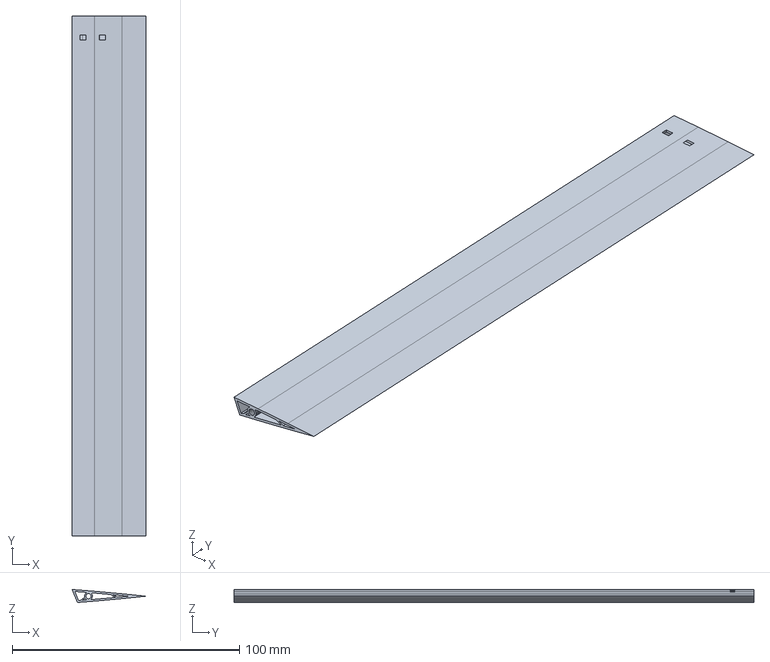
[picture p51: CAD file, 2026-10-05]
vtol-quadplane/cad/out/step/profondeur_3.step
32.5 x 229.0 x 5.74 mm
