Davdan11/Davdan11/vtol-quadplane/cad/out_mini/essais/5_cadre_servo_aile.stl

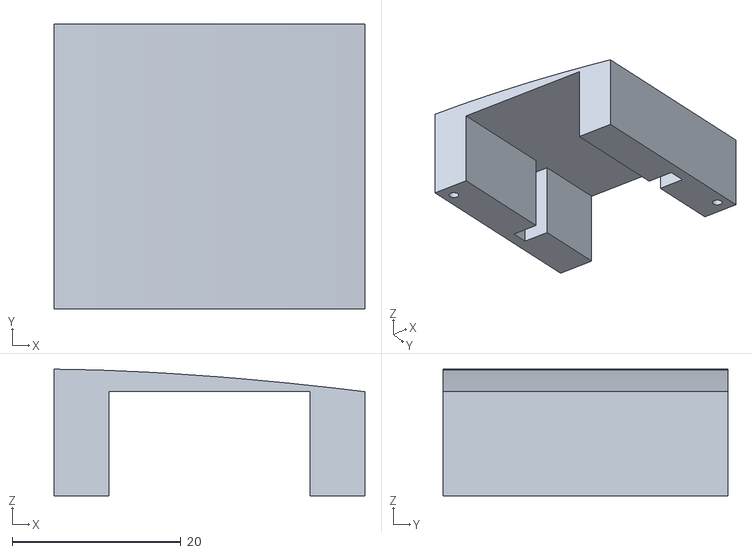
[picture p52: CAD file, 2026-10-05]
vtol-quadplane/cad/out_mini/essais/5_cadre_servo_aile.stl
36.9 x 33.8 x 15.0
