Davdan11/Davdan11/vtol-quadplane/cad/out_mini/step/aile_segment_3_droit.step

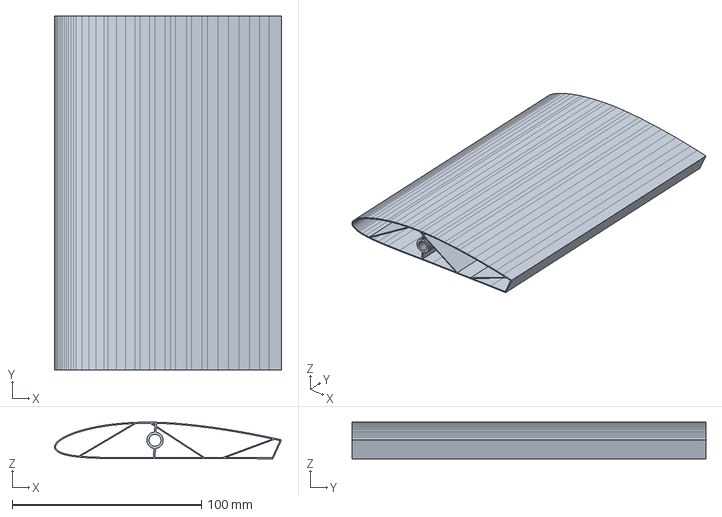
[picture p53: CAD file, 2026-10-05]
vtol-quadplane/cad/out_mini/step/aile_segment_3_droit.step
119.8 x 186.7 x 19.4 mm
