Davdan11/Davdan11/vtol-quadplane/cad/out/essais/4_support_moteur.stl

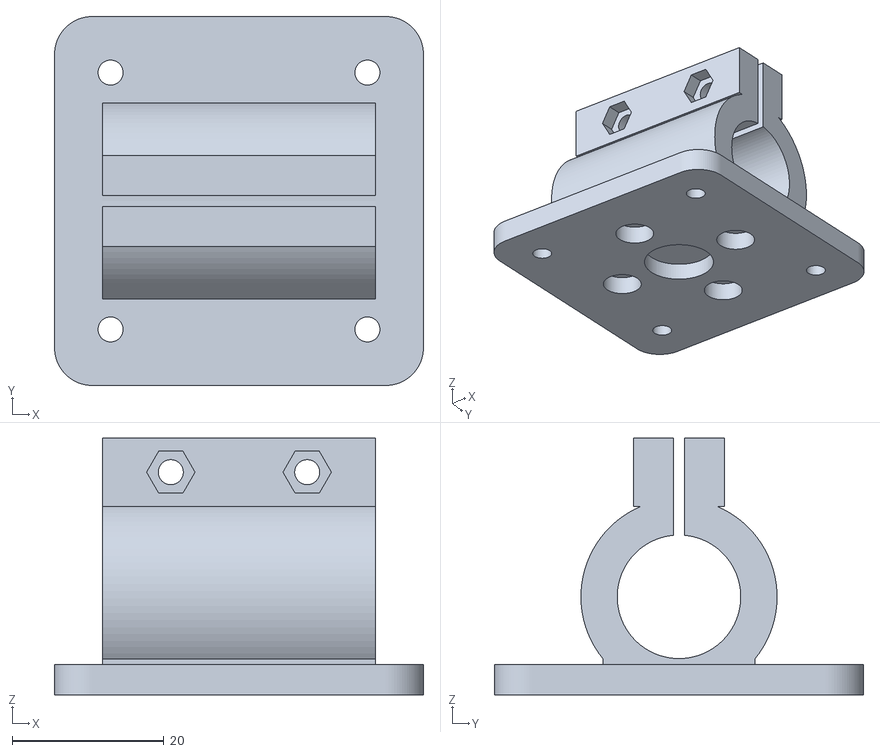
[picture p54: CAD file, 2026-10-04]
vtol-quadplane/cad/out/essais/4_support_moteur.stl
48.7 x 48.7 x 33.9
