Davdan11/Davdan11/vtol-quadplane/cad/out/step/cloison_moteur.step

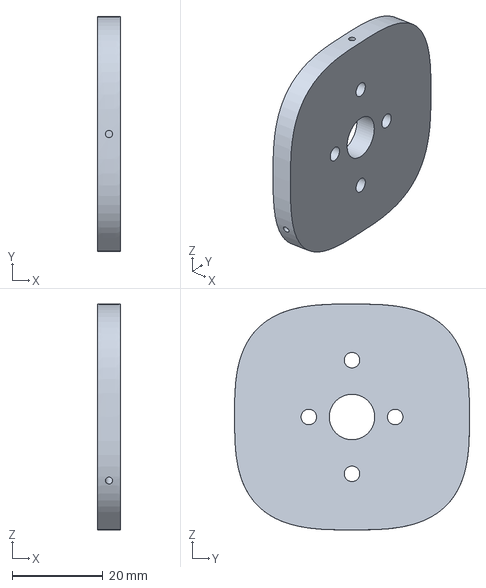
[picture p55: CAD file, 2026-10-05]
vtol-quadplane/cad/out/step/cloison_moteur.step
5.00 x 51.7 x 49.7 mm
