Davdan11/Davdan11/vtol-quadplane/cad/out_mini/essais/4_support_moteur.stl

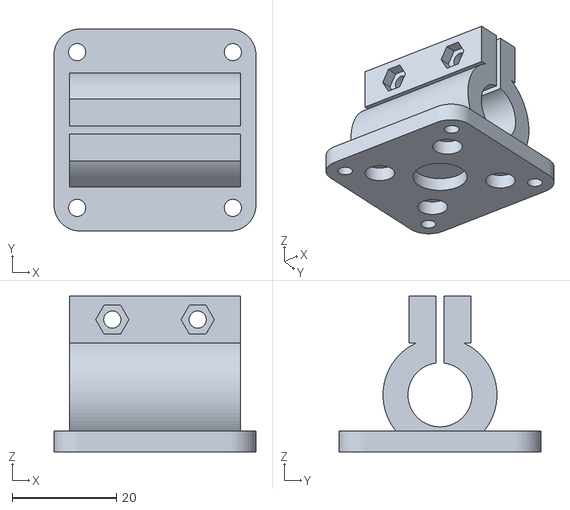
[picture p56: CAD file, 2026-10-04]
vtol-quadplane/cad/out_mini/essais/4_support_moteur.stl
38.8 x 38.8 x 29.9
