Davdan11/Davdan11/vtol-quadplane/cad/out_mini/step/plateau_electronique.step

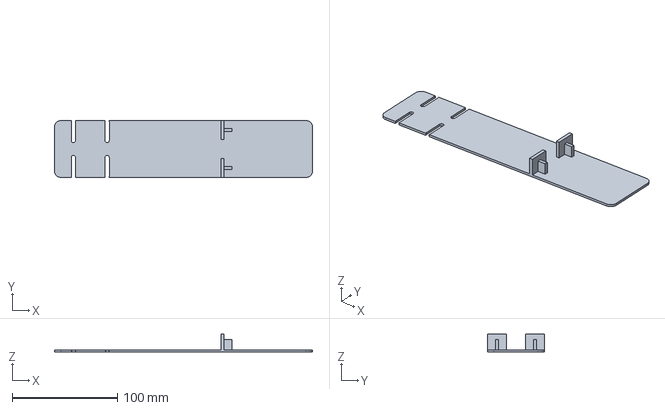
[picture p57: CAD file, 2026-10-05]
vtol-quadplane/cad/out_mini/step/plateau_electronique.step
245.0 x 54.0 x 17.0 mm
