Davdan11/Davdan11/vtol-quadplane/cad/out/step/trappe_acces.step

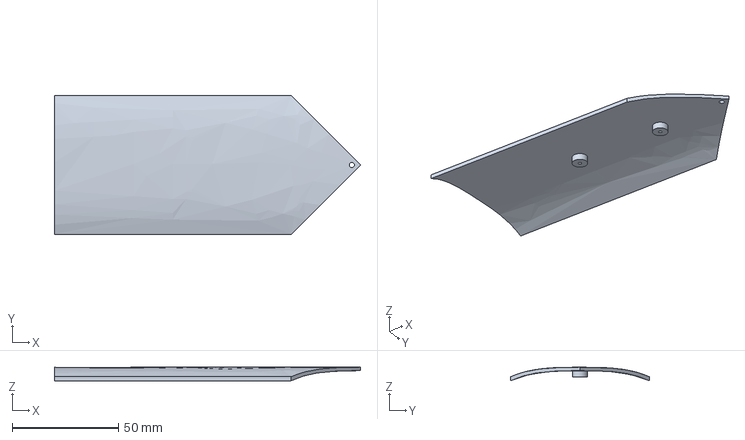
[picture p58: CAD file, 2026-10-05]
vtol-quadplane/cad/out/step/trappe_acces.step
144.3 x 65.4 x 6.38 mm
