Davdan11/Davdan11/vtol-quadplane/cad/out_mini/step/stab_segment_1.step

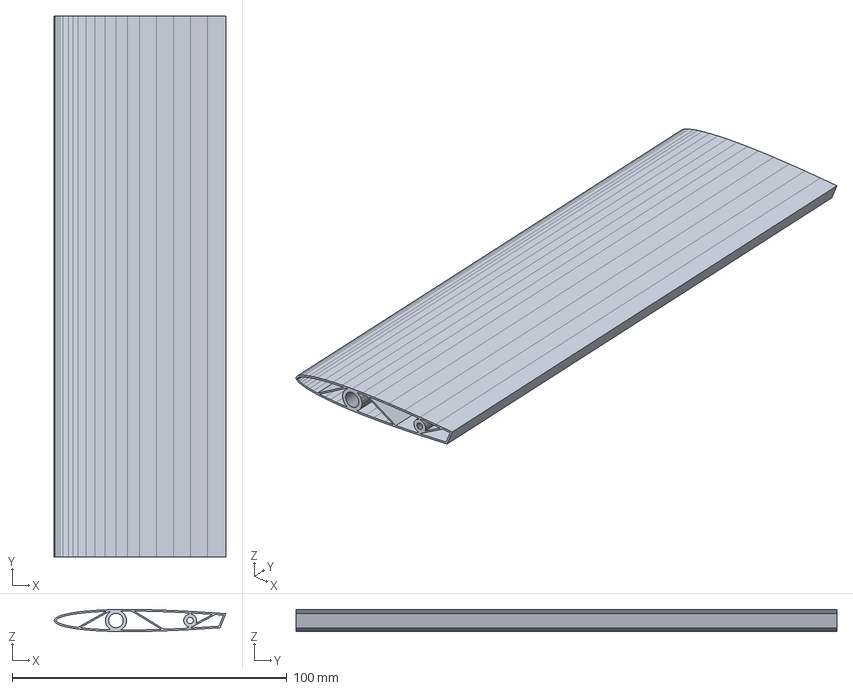
[picture p59: CAD file, 2026-10-05]
vtol-quadplane/cad/out_mini/step/stab_segment_1.step
62.5 x 197.0 x 8.10 mm
