Davdan11/Davdan11/vtol-quadplane/cad/out_mini/step/support_gps.step

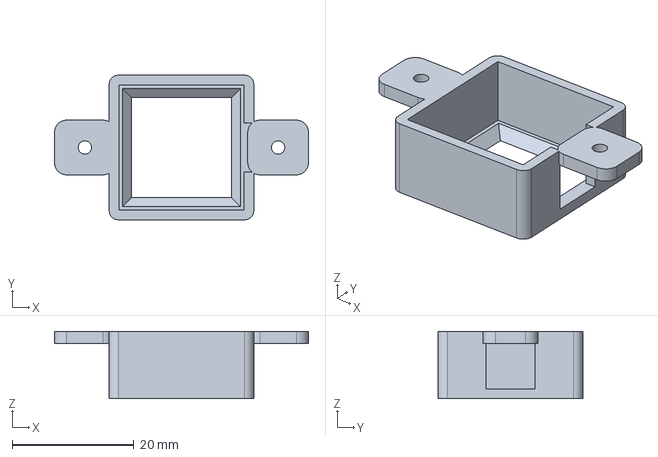
[picture p60: CAD file, 2026-10-05]
vtol-quadplane/cad/out_mini/step/support_gps.step
41.8 x 23.8 x 11.1 mm
