Davdan11/Davdan11/vtol-quadplane/cad/out/step/fuselage_queue.step

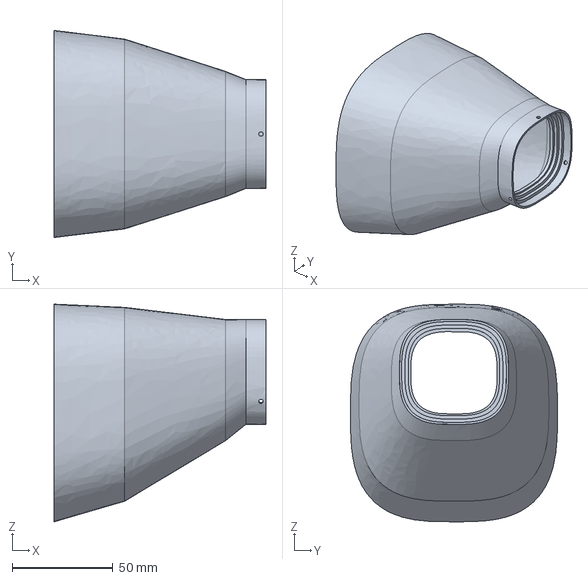
[picture p61: CAD file, 2026-10-05]
vtol-quadplane/cad/out/step/fuselage_queue.step
105.0 x 102.6 x 107.8 mm
