Davdan11/Davdan11/vtol-quadplane/cad/out/step/patte_atterrissage.step

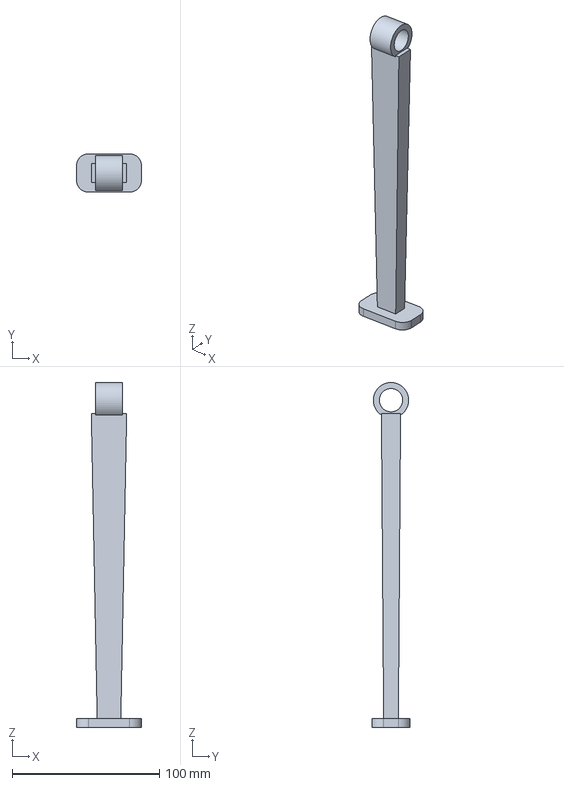
[picture p62: CAD file, 2026-10-05]
vtol-quadplane/cad/out/step/patte_atterrissage.step
44.0 x 26.0 x 234.0 mm
