Davdan11/Davdan11/vtol-quadplane/cad/out/step/trappe_servo_aile_droit.step

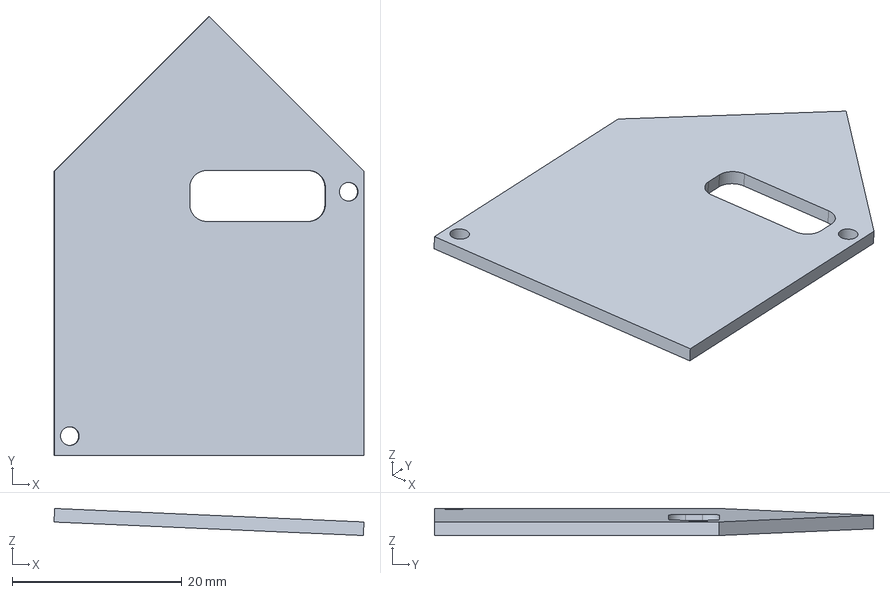
[picture p63: CAD file, 2026-10-05]
vtol-quadplane/cad/out/step/trappe_servo_aile_droit.step
36.5 x 51.8 x 3.19 mm
