Davdan11/Davdan11/vtol-quadplane/cad/out_mini/step/fuselage_queue.step

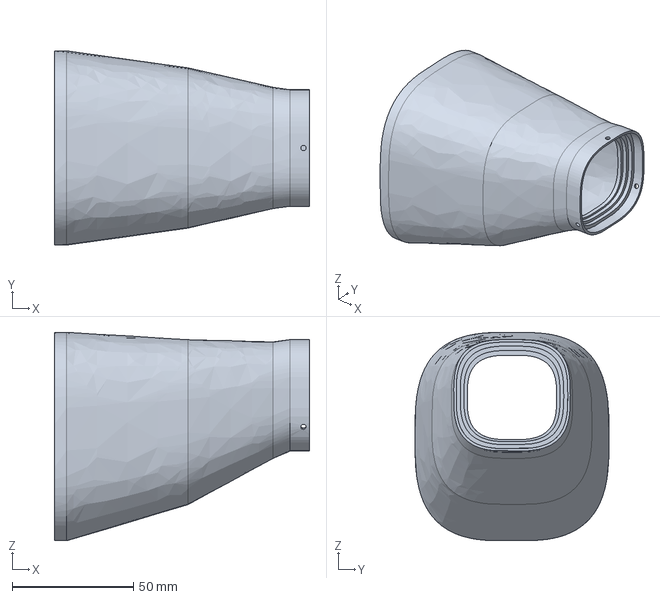
[picture p64: CAD file, 2026-10-05]
vtol-quadplane/cad/out_mini/step/fuselage_queue.step
105.0 x 80.0 x 85.8 mm
