Davdan11/Davdan11/vtol-quadplane/cad/out/step/cadre_servo_aile_gauche.step

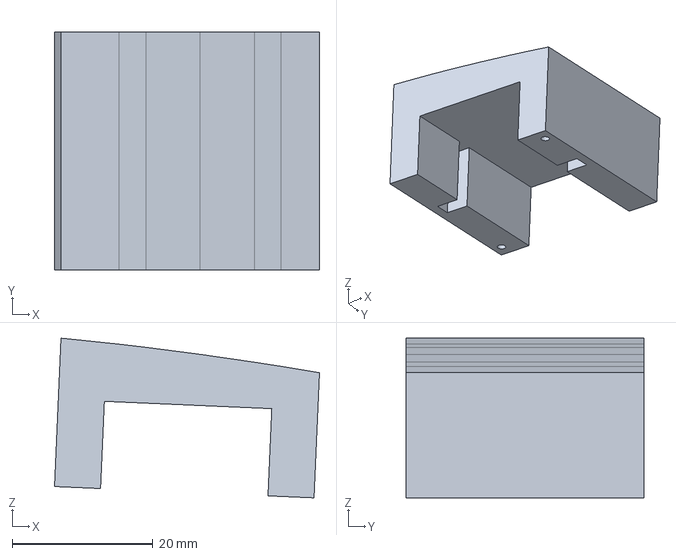
[picture p65: CAD file, 2026-10-05]
vtol-quadplane/cad/out/step/cadre_servo_aile_gauche.step
37.6 x 33.8 x 22.7 mm
