Davdan11/Davdan11/vtol-quadplane/cad/out_mini/step/fuselage_avant.step

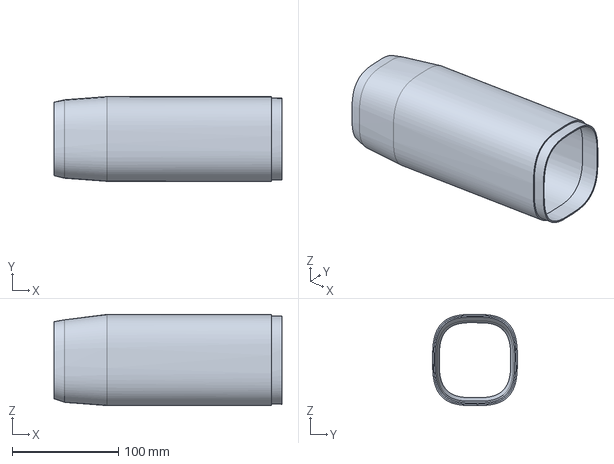
[picture p66: CAD file, 2026-10-05]
vtol-quadplane/cad/out_mini/step/fuselage_avant.step
215.0 x 80.0 x 86.0 mm
