Davdan11/Davdan11/vtol-quadplane/cad/out/step/fuselage_avant.step

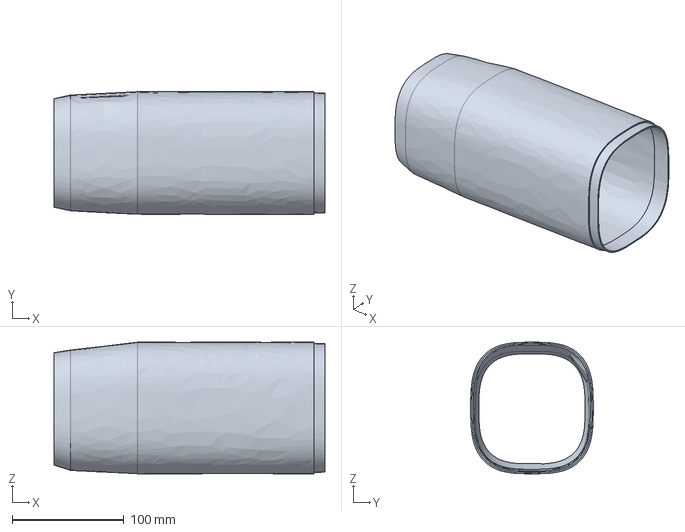
[picture p67: CAD file, 2026-10-05]
vtol-quadplane/cad/out/step/fuselage_avant.step
243.0 x 110.0 x 118.0 mm
