Davdan11/Davdan11/vtol-quadplane/cad/out_mini/step/saumon_droit.step

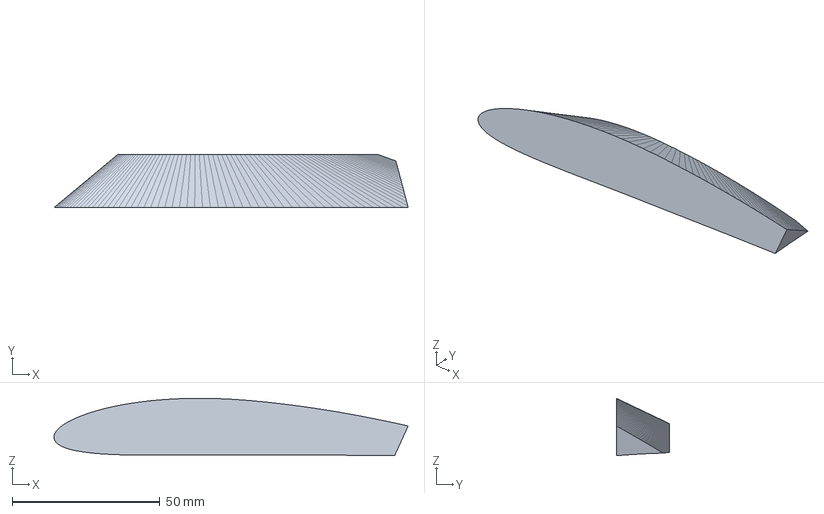
[picture p68: CAD file, 2026-10-05]
vtol-quadplane/cad/out_mini/step/saumon_droit.step
119.8 x 18.0 x 19.4 mm
