Davdan11/Davdan11/vtol-quadplane/cad/out_mini/step/aile_segment_1_gauche.step

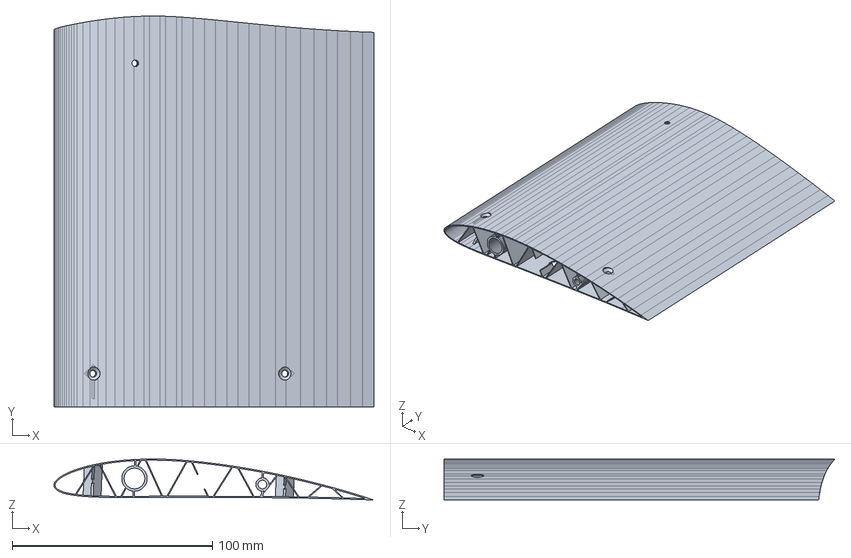
[picture p69: CAD file, 2026-10-05]
vtol-quadplane/cad/out_mini/step/aile_segment_1_gauche.step
159.8 x 195.3 x 20.5 mm
