Davdan11/Davdan11/vtol-quadplane/cad/out/step/support_nacelle.step

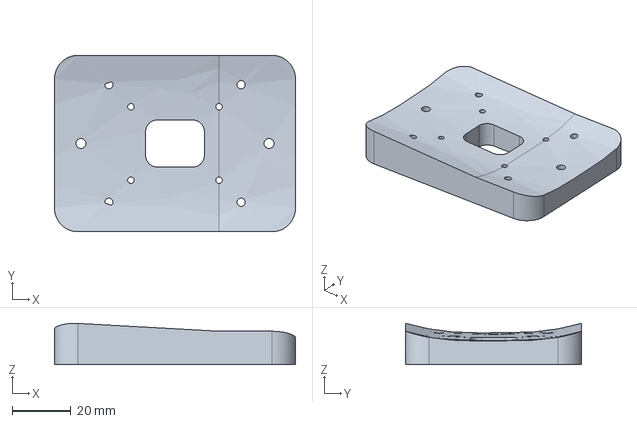
[picture p70: CAD file, 2026-10-05]
vtol-quadplane/cad/out/step/support_nacelle.step
82.0 x 60.0 x 14.1 mm
