Davdan11/Davdan11/vtol-quadplane/cad/out_mini/step/fuselage_nez.step

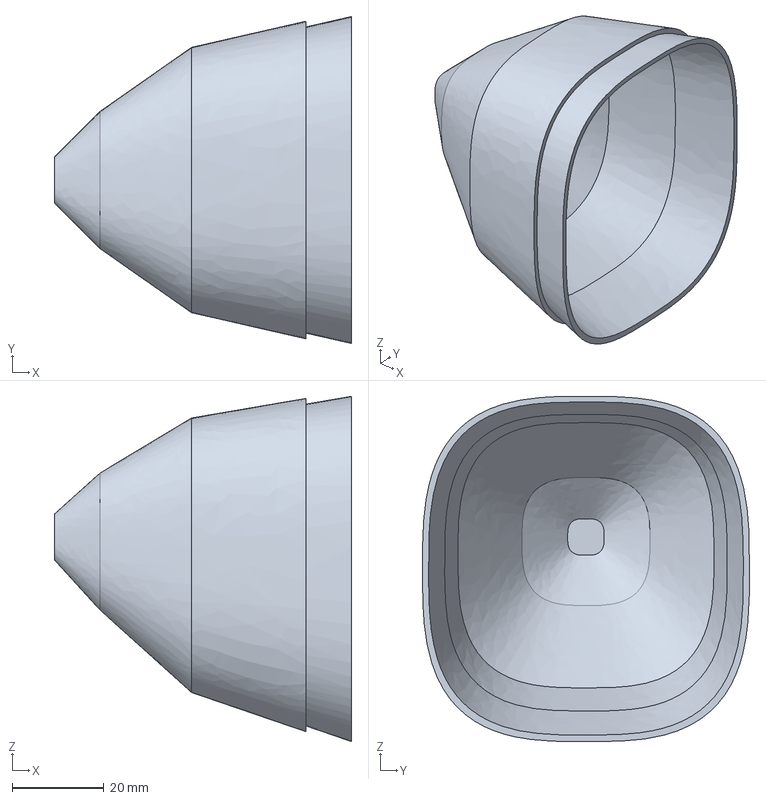
[picture p71: CAD file, 2026-10-05]
vtol-quadplane/cad/out_mini/step/fuselage_nez.step
65.0 x 71.5 x 75.5 mm
