Davdan11/Davdan11/vtol-quadplane/cad/out/step/plateau_electronique.step

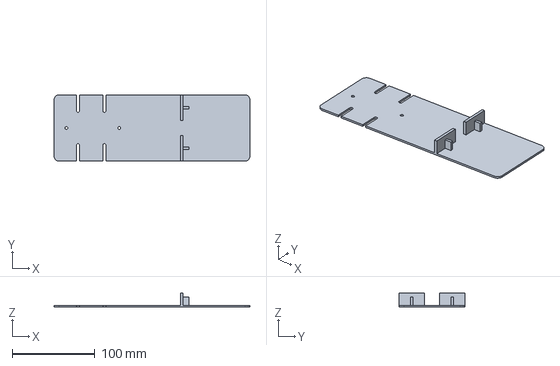
[picture p73: CAD file, 2026-10-05]
vtol-quadplane/cad/out/step/plateau_electronique.step
237.0 x 80.0 x 17.0 mm
