Davdan11/Davdan11/vtol-quadplane/cad/out_mini/step/profondeur_1.step

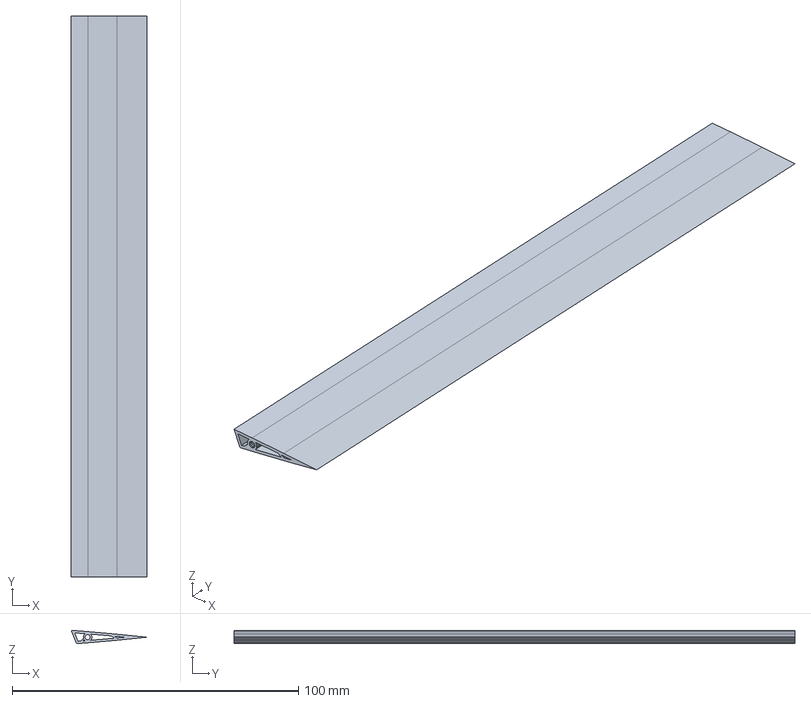
[picture p74: CAD file, 2026-10-05]
vtol-quadplane/cad/out_mini/step/profondeur_1.step
26.5 x 196.0 x 4.68 mm
