Davdan11/Davdan11/vtol-quadplane/cad/out/step/entretoise_plateau_arriere.step

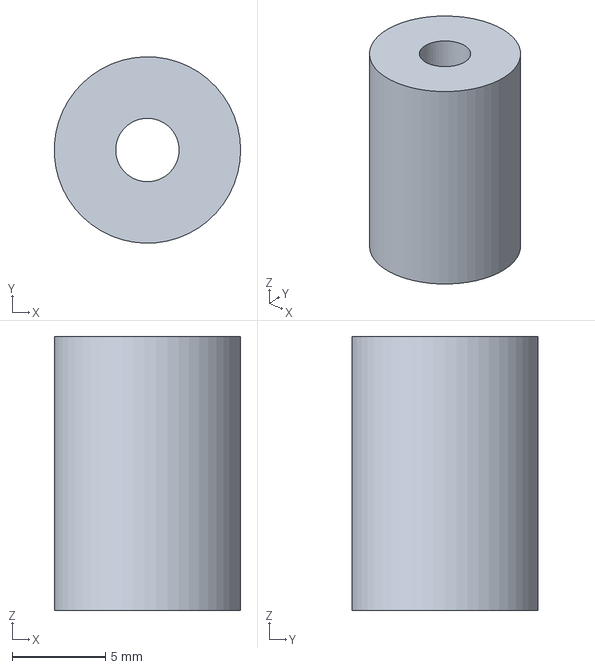
[picture p75: CAD file, 2026-10-05]
vtol-quadplane/cad/out/step/entretoise_plateau_arriere.step
9.99 x 10.00 x 14.7 mm
