Davdan11/Davdan11/vtol-quadplane/cad/out_mini/step/bloc_queue_droit.step

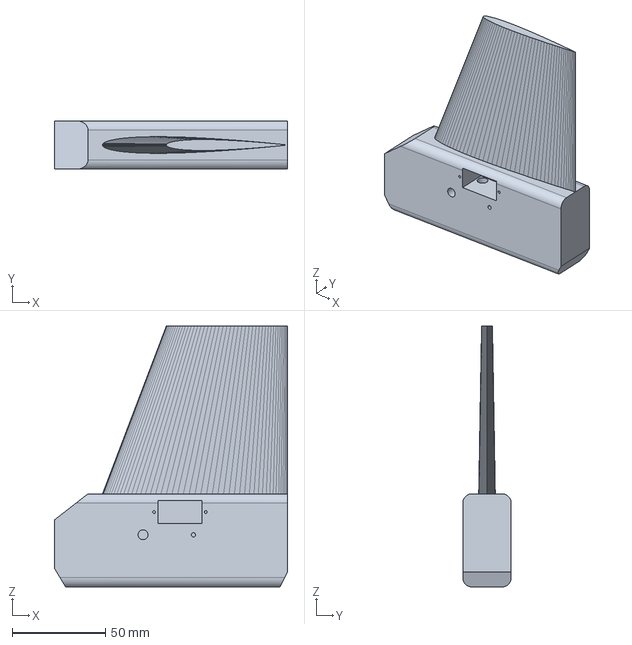
[picture p76: CAD file, 2026-10-05]
vtol-quadplane/cad/out_mini/step/bloc_queue_droit.step
125.0 x 26.0 x 140.0 mm
