Davdan11/Davdan11/vtol-quadplane/cad/out_mini/step/patte_atterrissage.step

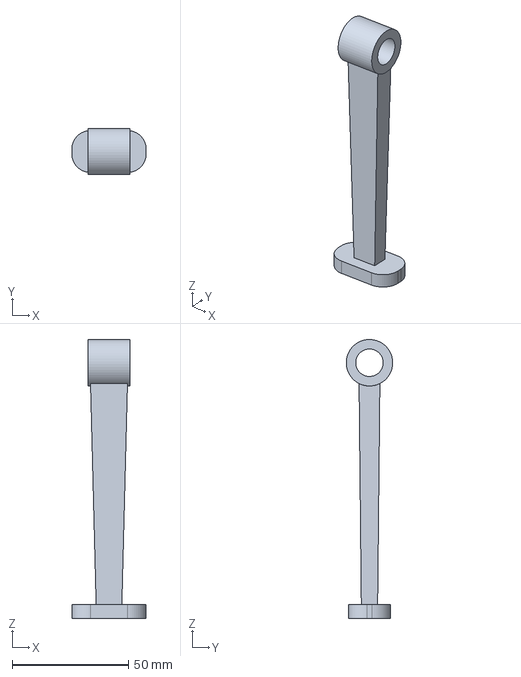
[picture p77: CAD file, 2026-10-05]
vtol-quadplane/cad/out_mini/step/patte_atterrissage.step
32.0 x 20.0 x 120.0 mm
