Davdan11/Davdan11/vtol-quadplane/cad/out/step/bloc_queue_droit.step

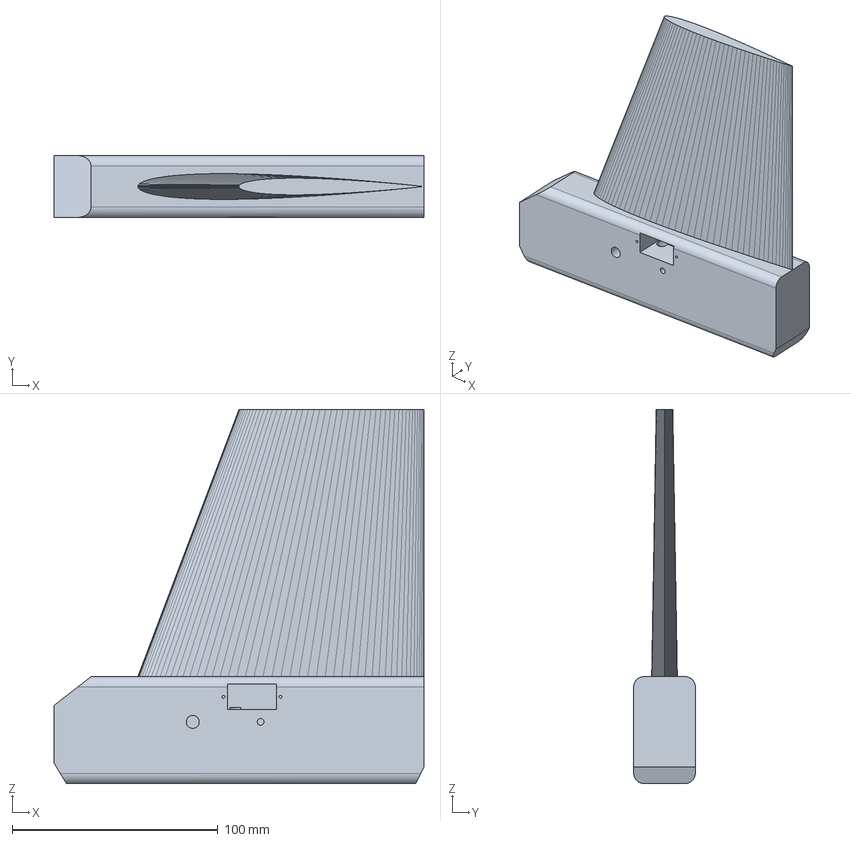
[picture p78: CAD file, 2026-10-05]
vtol-quadplane/cad/out/step/bloc_queue_droit.step
180.0 x 30.0 x 182.0 mm
