Davdan11/Davdan11/vtol-quadplane/cad/out_mini/step/cadre_servo_aile_gauche.step

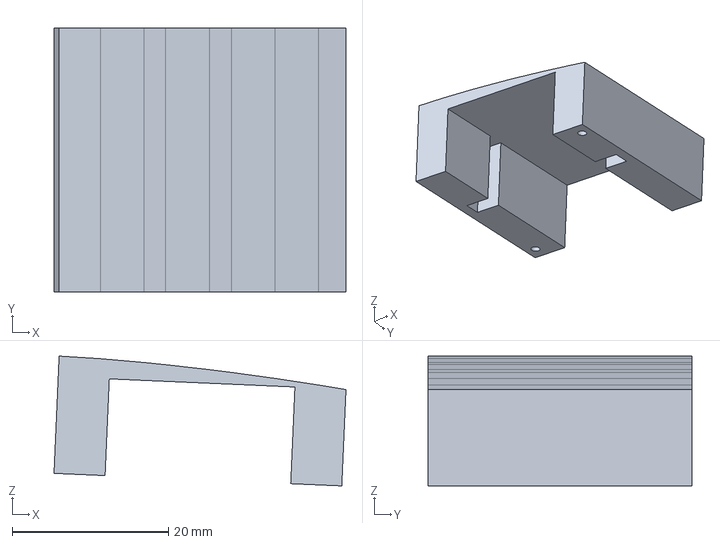
[picture p79: CAD file, 2026-10-05]
vtol-quadplane/cad/out_mini/step/cadre_servo_aile_gauche.step
37.4 x 33.8 x 16.6 mm
