Davdan11/Davdan11/vtol-quadplane/cad/out_mini/step/fuselage_milieu.step

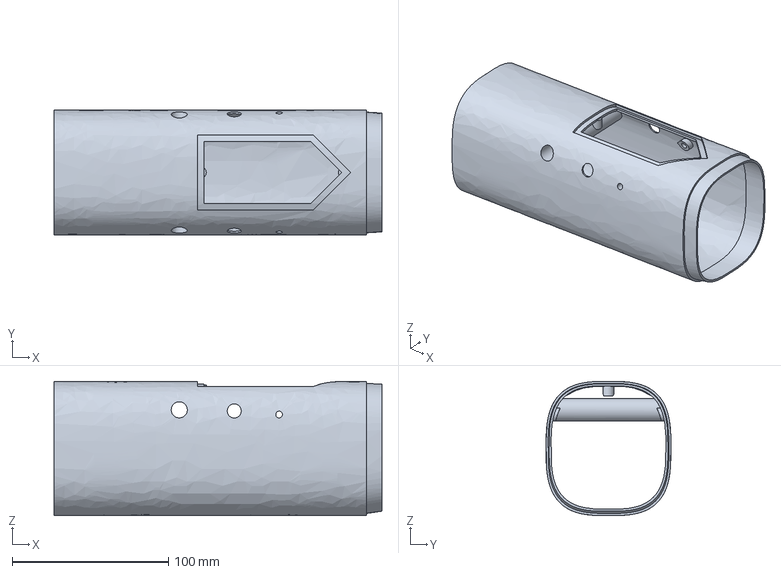
[picture p80: CAD file, 2026-10-05]
vtol-quadplane/cad/out_mini/step/fuselage_milieu.step
210.0 x 80.0 x 86.0 mm
