Davdan11/Davdan11/vtol-quadplane/cad/out_mini/step/plateau_compagnon.step

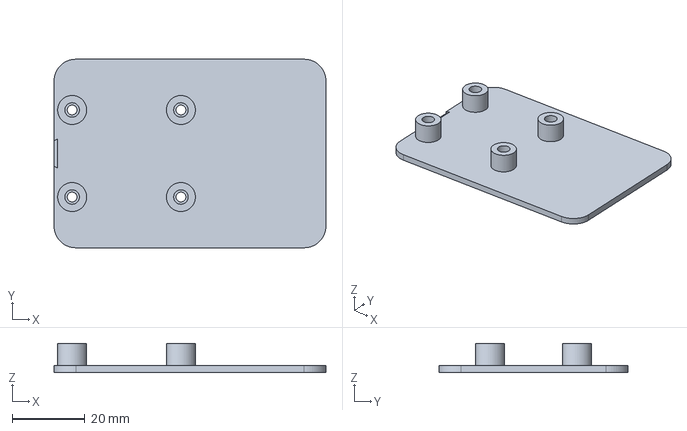
[picture p81: CAD file, 2026-10-05]
vtol-quadplane/cad/out_mini/step/plateau_compagnon.step
75.0 x 52.0 x 8.00 mm
