Davdan11/Davdan11/vtol-quadplane/cad/out/step/pylone_poutre_gauche.step

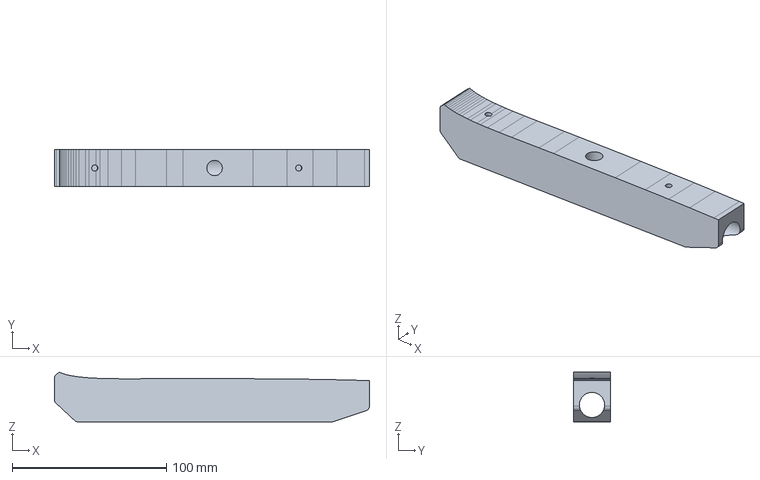
[picture p82: CAD file, 2026-10-05]
vtol-quadplane/cad/out/step/pylone_poutre_gauche.step
204.0 x 24.0 x 32.3 mm
