Davdan11/Davdan11/vtol-quadplane/cad/out_mini/step/guignol_profondeur.step

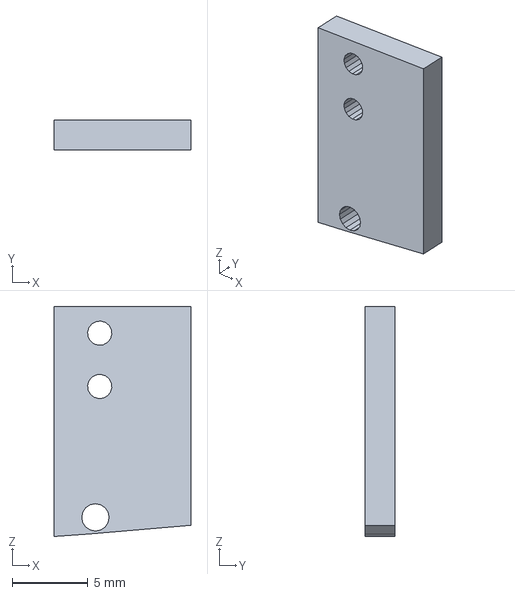
[picture p83: CAD file, 2026-10-05]
vtol-quadplane/cad/out_mini/step/guignol_profondeur.step
9.00 x 2.00 x 15.1 mm
