Davdan11/Davdan11/vtol-quadplane/cad/out/step/guignol_profondeur.step

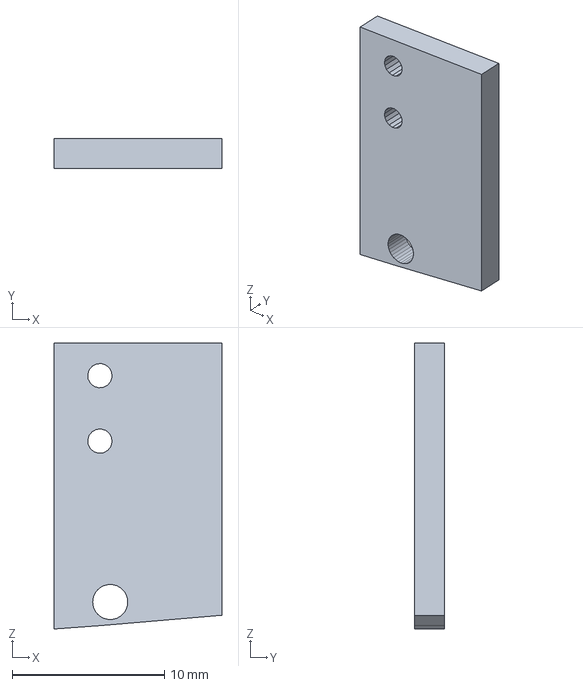
[picture p84: CAD file, 2026-10-05]
vtol-quadplane/cad/out/step/guignol_profondeur.step
11.0 x 2.00 x 18.8 mm
