Davdan11/Davdan11/vtol-quadplane/cad/out/step/fuselage_nez.step

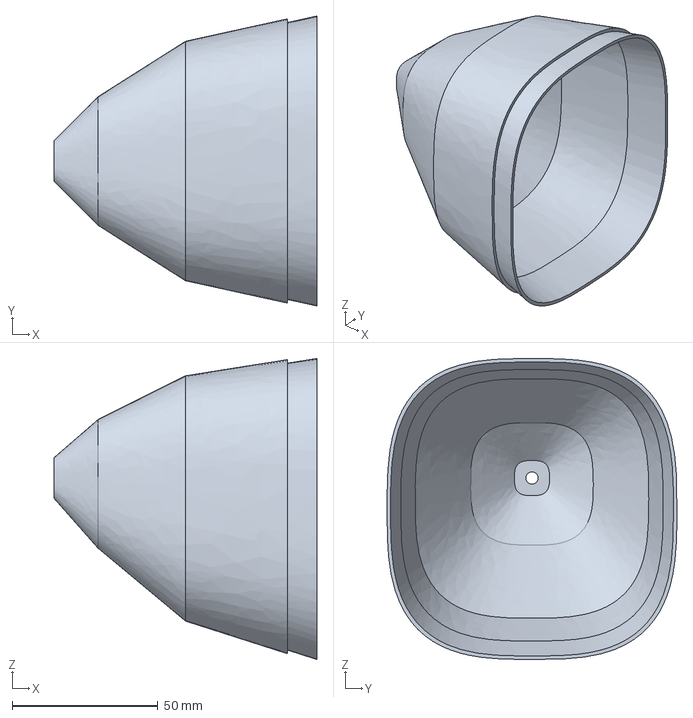
[picture p85: CAD file, 2026-10-05]
vtol-quadplane/cad/out/step/fuselage_nez.step
90.0 x 99.3 x 103.1 mm
