Davdan11/Davdan11/vtol-quadplane/cad/out/step/aile_segment_3_gauche.step

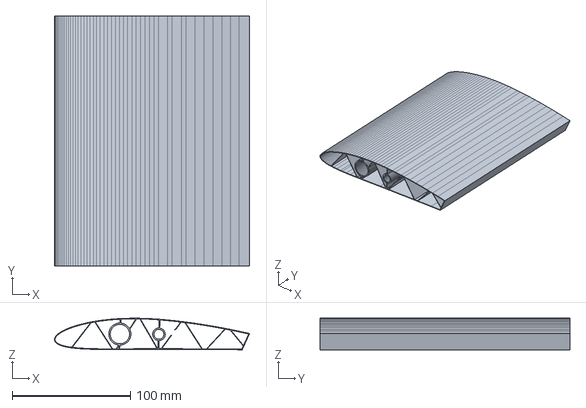
[picture p86: CAD file, 2026-10-05]
vtol-quadplane/cad/out/step/aile_segment_3_gauche.step
164.9 x 211.2 x 26.7 mm
