Davdan11/Davdan11/vtol-quadplane/cad/out/step/entretoise_plateau_avant.step

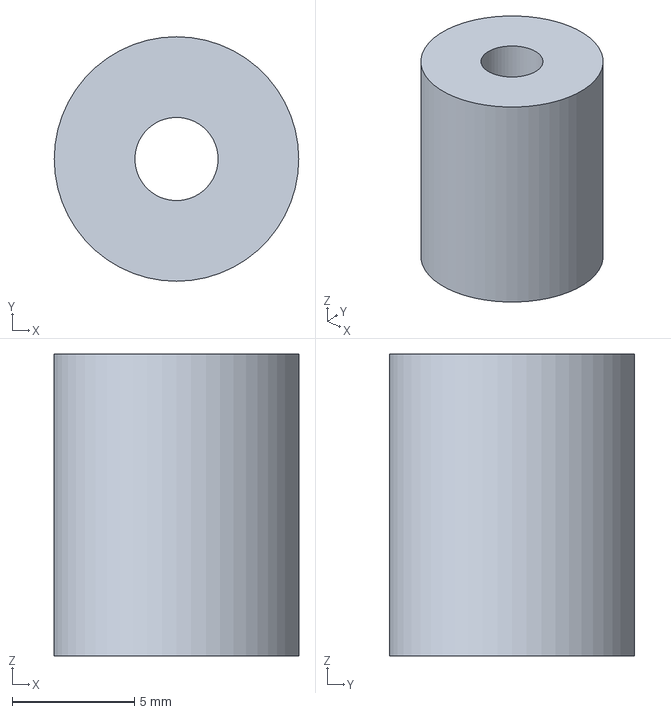
[picture p87: CAD file, 2026-10-05]
vtol-quadplane/cad/out/step/entretoise_plateau_avant.step
10.0 x 10.0 x 12.3 mm
