Davdan11/Davdan11/(list of files, cad)

Other CAD files:
vtol-quadplane/cad/out_mini/step/pylone_poutre_droit.step
vtol-quadplane/cad/out/essais/5_trappe_servo_aile.stl
vtol-quadplane/cad/out/step/aileron_2_droit.step
vtol-quadplane/cad/out/step/stab_segment_2.step
vtol-quadplane/cad/out_mini/step/aile_segment_2_droit.step
vtol-quadplane/cad/out_mini/step/support_moteur.step
vtol-quadplane/cad/out_mini/step/stab_segment_2.step
vtol-quadplane/cad/out_mini/step/trappe_servo_aile_droit.step
vtol-quadplane/cad/out/step/aile_segment_2_gauche.step
vtol-quadplane/cad/out/step/profondeur_1.step
vtol-quadplane/cad/out/step/guignol_aileron.step
vtol-quadplane/cad/out_mini/step/trappe_servo_aile_gauche.step
vtol-quadplane/cad/out_mini/step/aile_segment_1_droit.step
vtol-quadplane/cad/out/step/cadre_servo_aile_droit.step
vtol-quadplane/cad/out_mini/step/platine_moteur.step
vtol-quadplane/cad/out/step/bloc_queue_gauche.step
vtol-quadplane/cad/out_mini/step/guignol_aileron.step
vtol-quadplane/cad/out/step/aileron_1_gauche.step
vtol-quadplane/cad/out/step/platine_moteur.step
vtol-quadplane/cad/out/step/aileron_2_gauche.step
vtol-quadplane/cad/out_mini/step/profondeur_2.step
vtol-quadplane/cad/out/step/saumon_gauche.step
vtol-quadplane/cad/out_mini/step/aile_segment_3_gauche.step
vtol-quadplane/cad/out/step/profondeur_2.step
vtol-quadplane/cad/out/step/support_moteur.step
vtol-quadplane/cad/out_mini/step/bloc_queue_gauche.step
vtol-quadplane/cad/out_mini/step/aileron_1_gauche.step
vtol-quadplane/cad/out/step/stab_segment_3.step
vtol-quadplane/cad/out_mini/step/saumon_gauche.step
vtol-quadplane/cad/out_mini/step/aileron_2_gauche.step
vtol-quadplane/cad/out/step/aile_segment_1_droit.step
vtol-quadplane/cad/out_mini/step/cadre_servo_aile_droit.step
vtol-quadplane/cad/out/step/fuselage_milieu.step
vtol-quadplane/cad/out/step/trappe_servo_aile_gauche.step
vtol-quadplane/cad/out/step/aile_segment_3_droit.step
vtol-quadplane/cad/out/step/aile_segment_4_droit.step
vtol-quadplane/cad/out/step/pylone_poutre_droit.step
vtol-quadplane/cad/out/stl/aile_segment_1_droit.stl
vtol-quadplane/cad/out/stl/aile_segment_1_gauche.stl
vtol-quadplane/cad/out/stl/aile_segment_2_droit.stl
vtol-quadplane/cad/out/stl/aile_segment_2_gauche.stl
vtol-quadplane/cad/out/stl/aile_segment_3_droit.stl
vtol-quadplane/cad/out/stl/aile_segment_3_gauche.stl
vtol-quadplane/cad/out/stl/aile_segment_4_droit.stl
vtol-quadplane/cad/out/stl/aile_segment_4_gauche.stl
vtol-quadplane/cad/out/stl/aileron_1_droit.stl
vtol-quadplane/cad/out/stl/aileron_1_gauche.stl
vtol-quadplane/cad/out/stl/aileron_2_droit.stl
vtol-quadplane/cad/out/stl/aileron_2_gauche.stl
vtol-quadplane/cad/out/stl/bloc_queue_droit.stl
vtol-quadplane/cad/out/stl/bloc_queue_gauche.stl
vtol-quadplane/cad/out/stl/cadre_servo_aile_gauche.stl
vtol-quadplane/cad/out/stl/cloison_moteur.stl
vtol-quadplane/cad/out/stl/entretoise_plateau_arriere.stl
vtol-quadplane/cad/out/stl/entretoise_plateau_avant.stl
vtol-quadplane/cad/out/stl/fuselage_avant.stl
vtol-quadplane/cad/out/stl/fuselage_milieu.stl
vtol-quadplane/cad/out/stl/fuselage_nez.stl
vtol-quadplane/cad/out/stl/fuselage_queue.stl
vtol-quadplane/cad/out/stl/guignol_profondeur.stl
vtol-quadplane/cad/out/stl/patte_atterrissage.stl
vtol-quadplane/cad/out/stl/plateau_compagnon.stl
vtol-quadplane/cad/out/stl/plateau_electronique.stl
vtol-quadplane/cad/out/stl/profondeur_1.stl
vtol-quadplane/cad/out/stl/profondeur_2.stl
vtol-quadplane/cad/out/stl/profondeur_3.stl
vtol-quadplane/cad/out/stl/pylone_poutre_droit.stl
vtol-quadplane/cad/out/stl/pylone_poutre_gauche.stl
vtol-quadplane/cad/out/stl/saumon_droit.stl
vtol-quadplane/cad/out/stl/saumon_gauche.stl
vtol-quadplane/cad/out/stl/stab_segment_1.stl
vtol-quadplane/cad/out/stl/stab_segment_2.stl
vtol-quadplane/cad/out/stl/stab_segment_3.stl
vtol-quadplane/cad/out/stl/support_gps.stl
vtol-quadplane/cad/out/stl/support_nacelle.stl
vtol-quadplane/cad/out/stl/trappe_acces.stl
vtol-quadplane/cad/out/stl/trappe_servo_aile_droit.stl
vtol-quadplane/cad/out/stl/trappe_servo_aile_gauche.stl
vtol-quadplane/cad/out_mini/stl/aile_segment_1_droit.stl
vtol-quadplane/cad/out_mini/stl/aile_segment_1_gauche.stl
vtol-quadplane/cad/out_mini/stl/aile_segment_2_droit.stl
vtol-quadplane/cad/out_mini/stl/aile_segment_2_gauche.stl
vtol-quadplane/cad/out_mini/stl/aile_segment_3_droit.stl
vtol-quadplane/cad/out_mini/stl/aile_segment_3_gauche.stl
vtol-quadplane/cad/out_mini/stl/aileron_1_droit.stl
vtol-quadplane/cad/out_mini/stl/aileron_1_gauche.stl
vtol-quadplane/cad/out_mini/stl/aileron_2_droit.stl
vtol-quadplane/cad/out_mini/stl/aileron_2_gauche.stl
vtol-quadplane/cad/out_mini/stl/bloc_queue_droit.stl
vtol-quadplane/cad/out_mini/stl/bloc_queue_gauche.stl
vtol-quadplane/cad/out_mini/stl/cadre_servo_aile_gauche.stl
vtol-quadplane/cad/out_mini/stl/cloison_moteur.stl
vtol-quadplane/cad/out_mini/stl/fuselage_avant.stl
vtol-quadplane/cad/out_mini/stl/fuselage_milieu.stl
vtol-quadplane/cad/out_mini/stl/fuselage_nez.stl
vtol-quadplane/cad/out_mini/stl/fuselage_queue.stl
vtol-quadplane/cad/out_mini/stl/guignol_profondeur.stl
vtol-quadplane/cad/out_mini/stl/patte_atterrissage.stl
vtol-quadplane/cad/out_mini/stl/plateau_compagnon.stl
vtol-quadplane/cad/out_mini/stl/plateau_electronique.stl
vtol-quadplane/cad/out_mini/stl/profondeur_1.stl
vtol-quadplane/cad/out_mini/stl/profondeur_2.stl
vtol-quadplane/cad/out_mini/stl/pylone_poutre_droit.stl
vtol-quadplane/cad/out_mini/stl/pylone_poutre_gauche.stl
vtol-quadplane/cad/out_mini/stl/saumon_droit.stl
vtol-quadplane/cad/out_mini/stl/saumon_gauche.stl
vtol-quadplane/cad/out_mini/stl/stab_segment_1.stl
vtol-quadplane/cad/out_mini/stl/stab_segment_2.stl
vtol-quadplane/cad/out_mini/stl/support_gps.stl
vtol-quadplane/cad/out_mini/stl/trappe_acces.stl
vtol-quadplane/cad/out_mini/stl/trappe_servo_aile_gauche.stl
