Davdan11/Davdan11/(commit log)

2026-10-04 Quadplane VTOL Huard : CAO paramétrique imprimable, bilan, nomenclature, paramètres ArduPilot
    Pièces CadQuery pour Bambu Lab A1 (STL orientés, STEP, assemblage GLB),
    calcul de masse et d'autonomie, liste d'achats et paramètres de départ.
    Claude-Session: https://claude.ai/code/session_01RLKEH34uiBSjns8giEMRtR
    [aile_segment_1_droit.step, aile_segment_1_droit.stl, aile_segment_1_gauche.step, aile_segment_1_gauche.stl, aile_segment_2_droit.step, aile_segment_2_droit.stl, aile_segment_2_gauche.step, aile_segment_2_gauche.stl]
2026-10-04 Huard DFR : version premier intervenant pour la police
    Nacelle caméra zoom + thermique, ordinateur de bord et modem 4G pour la
    vidéo en direct, passage en 6S avec hélices VTOL de 13 po, fuselage allongé
    en 4 tronçons pour centrer sans lest, calcul du centrage et du temps
    disponible sur les lieux selon la distance, concept du système complet.
    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
    [aile_segment_1_droit.step, aile_segment_1_gauche.step, aile_segment_2_droit.step, aile_segment_2_gauche.step, aile_segment_3_droit.step, aile_segment_3_gauche.step, aile_segment_4_droit.step, aile_segment_4_gauche.step]
2026-10-04 Huard DFR : modèles exacts avec liens et CAD calé sur leurs cotes
    Moteurs T-Motor MN4014 + hélices 15 po (les 13 po ne donnaient pas la
    poussée), poutres à ±360 mm, supports percés Ø25, cloison percée pour le
    SunnySky X2820, contrôleur TBS Lucid H7 Wing (le Matek H743-WING n'est plus
    fabriqué), batterie GAONENG 6S3P, selle percée pour SIYI A8 mini et ZT6,
    pattes rallongées. Vérification d'encombrement et centrage sans lest.
    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
    [aile_segment_1_droit.step, aile_segment_1_gauche.step, aile_segment_2_droit.step, aile_segment_2_droit.stl, aile_segment_2_gauche.step, aile_segment_2_gauche.stl, aile_segment_3_droit.step, aile_segment_3_gauche.step]
2026-10-04 CAD : deux versions (DFR 1,8 m et Mini 1,2 m) depuis le même modèle
    Les cotes encore codées en dur dans les pièces viennent maintenant des
    paramètres. HUARD_VERSION=mini génère la version d'essai dans cad/out_mini.
    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
    [aile_segment_1_droit.step, aile_segment_1_droit.stl, aile_segment_1_gauche.step, aile_segment_1_gauche.stl, aile_segment_2_droit.step, aile_segment_2_droit.stl, aile_segment_2_gauche.step, aile_segment_2_gauche.stl]
2026-10-04 Huard Mini : version d'essai à petit budget (1,2 m, 4S, ≈ 670 $ CA)
    Pièces FPV en stock au Canada, CAD percé pour l'Emax ECO III 2807 et
    l'AtomRC F405 NAVI, nez allongé pour centrer sans lest, bilan, liste
    d'achats avec liens et paramètres ArduPilot.
    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
    [aile_segment_1_droit.step, aile_segment_1_gauche.step, aile_segment_2_droit.step, aile_segment_2_gauche.step, aile_segment_3_droit.step, aile_segment_3_gauche.step, aileron_1_droit.step, aileron_1_gauche.step]
2026-10-04 Gouvernes renforcées et guignols, passage du fil de servo
    Les fourreaux des joncs et longerons sont reliés aux peaux par une âme
    verticale (ils flottaient dans le vide), peau des gouvernes à 0,8 mm avec
    âmes internes, guignols PETG glissés dans une fente et enfilés sur le jonc,
    baie de servo d'aileron agrandie et percée pour le fil, coupe explicative.
    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
    [aile_segment_1_droit.step, aile_segment_1_droit.stl, aile_segment_1_gauche.step, aile_segment_1_gauche.stl, aile_segment_2_droit.step, aile_segment_2_droit.stl, aile_segment_2_gauche.step, aile_segment_2_gauche.stl]
2026-10-04 Servos : cadre PETG + trappe vissée dans l'aile, vissage du servo de profondeur
    Le servo d'aileron s'emboîte dans un cadre collé dans l'aile (oreilles
    dans des encoches) et est tenu par une trappe à 2 vis M2 : démontable.
    Position choisie automatiquement là où l'aile est la plus épaisse ;
    longeron extérieur du Mini avancé à 33 % pour faire la place. Le servo de
    profondeur se visse par ses oreilles sur la face du bloc de queue.
    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
    [aile_segment_1_droit.step, aile_segment_1_gauche.step, aile_segment_2_droit.step, aile_segment_2_droit.stl, aile_segment_2_gauche.step, aile_segment_2_gauche.stl, aile_segment_3_droit.step, aile_segment_3_droit.stl]
2026-10-04 Supports moteurs VTOL en deux pièces : collier + platine
    Les vis du moteur étaient inaccessibles une fois le support sur la poutre.
    Le moteur se visse maintenant sur une platine à l'établi, puis la platine
    se fixe sur la bride du collier par 4 vis de coin passées par-dessous, à
    côté du tube. Écrous du collier logés, vue éclatée dans docs/images.
    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
    [aile_segment_1_droit.step, aile_segment_1_gauche.step, aile_segment_2_droit.step, aile_segment_2_gauche.step, aile_segment_3_droit.step, aile_segment_3_gauche.step, aile_segment_4_droit.step, aile_segment_4_gauche.step]
2026-10-04 Contrôleur de vol : trappe d'accès, inserts laiton, plateau collé
    Le contrôleur était inaccessible une fois le fuselage collé. Trappe PETG
    sur le dessus du fuselage (feuillure + 2 vis M2) au-dessus du contrôleur,
    entretoises prévues pour inserts laiton M3/M2.5, flèche « avant » gravée
    sur le plateau. Calculs de fuselage mis en cache.
    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
    [aile_segment_1_droit.step, aile_segment_1_gauche.step, aile_segment_2_droit.step, aile_segment_2_gauche.step, aile_segment_3_droit.step, aile_segment_3_gauche.step, aile_segment_4_droit.step, aile_segment_4_gauche.step]
2026-10-04 Batterie : butée arrière de centrage, sangles accessibles, jonction du nez reculée
    La batterie se pousse contre une butée placée pour le centrage, les 2
    sangles sont près de l'ouverture du nez. Le contrôle d'interférence a
    montré que plateau et batterie touchaient la lèvre du nez : jonction
    reculée (DFR -205, Mini -245) et tronçons réajustés pour rester ≤ 252 mm.
    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
    [aile_segment_1_droit.step, aile_segment_1_gauche.step, aile_segment_2_droit.step, aile_segment_2_gauche.step, aile_segment_3_droit.step, aile_segment_3_gauche.step, aile_segment_4_droit.step, aile_segment_4_gauche.step]
2026-10-04 README : cotes de pylônes et longerons à jour
    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
2026-10-04 Intégration : charnières en V, conduit de câbles, retenue d'aile, cloison démontable, vérification (en cours)
    Code source et documentation ; les STL seront régénérés après la
    vérification d'intégration complète.
    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
2026-10-04 Vérification : jeux de collage (pylône, cadre de servo), ESC propulseur et modem replacés
    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
2026-10-05 Modem 4G sous le plafond avant, centrage recalé, sangles alignées sur la batterie, pièces et images régénérées
    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
    [aile_segment_1_droit.step, aile_segment_1_droit.stl, aile_segment_1_gauche.step, aile_segment_1_gauche.stl, aile_segment_2_droit.step, aile_segment_2_droit.stl, aile_segment_2_gauche.step, aile_segment_2_gauche.stl]
2026-10-05 Vérification d'intégration complète : tout passe sur les deux versions
    Rapports docs/verification.md et docs/verification_mini.md, limites
    documentées, README à jour (section vérification, ESC du propulseur).
    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
2026-10-05 Imprimabilité : lèvres du fuselage reliées à leur tronçon, entretoises de plateau séparées, trappe debout, intérieur du nez conique
    L'analyse des surplombs a montré que les lèvres d'emboîtement flottaient
    (0,25 mm de la peau) et que le plateau du DFR et la trappe s'imprimaient
    en l'air. Contrôle d'imprimabilité ajouté à verification.py.
    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
    [aile_segment_1_droit.step, aile_segment_1_gauche.step, aile_segment_2_droit.step, aile_segment_2_gauche.step, aile_segment_3_droit.step, aile_segment_3_gauche.step, aile_segment_4_droit.step, aile_segment_4_gauche.step]
2026-10-05 Lèvres du fuselage : collet arrêté pile à la jonction (plus aucun chevauchement), pièces régénérées
    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
    [aile_segment_1_droit.step, aile_segment_1_gauche.step, aile_segment_2_droit.step, aile_segment_2_gauche.step, aile_segment_3_droit.step, aile_segment_3_gauche.step, aile_segment_4_droit.step, aile_segment_4_gauche.step]
2026-10-05 Rapports de vérification : tout passe, imprimabilité comprise
    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
2026-10-05 Kit d'essai : jauge de tubes, tranche d'aile, jonction de fuselage et vraies petites pièces
    Quelques grammes de filament pour valider tous les ajustements avant
    d'imprimer l'avion complet (outils_essais.py, section du README).
    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
    [1_jauge_tubes.stl, 2_tranche_aile.stl, 3_jonction_cote_avant.stl, 3_jonction_cote_milieu.stl, 4_platine_moteur.stl, 4_support_moteur.stl, 5_cadre_servo_aile.stl, 5_trappe_servo_aile.stl]
2026-10-05 Imprimabilité : plus aucune couche dans le vide
    - Ailerons jusqu'au bout de l'aile : supprime la mince bande pleine de 4 mm
    imprimée dans le vide en haut du segment extérieur (saumon limité à la partie fixe)
    - Baie du servo d'aileron, trappe d'accès : bout en pointe à 45° au lieu d'un pont
    - Fourreau du longeron principal : voile à 45° sous la goutte ; goupille tenue
    par deux bossages courts (le conduit de câbles passe devant)
    - Bossages des vis de trappe chanfreinés ; DFR : ailerons calés sur le joint de segment
    - verification.py : contrôle couche par couche (porte_a_faux.py), comme le trancheur
    Claude-Session: https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
    [1_jauge_tubes.stl, 3_jonction_cote_milieu.stl, 5_cadre_servo_aile.stl, 5_trappe_servo_aile.stl, 6_guignol_aileron.stl, aile_segment_1_droit.step, aile_segment_1_gauche.step, aile_segment_2_droit.step]
2026-10-05 Essais virtuels : pression, charges de vol, résistance, stabilité, servos
    - calc/essais_virtuels.py : méthode des panneaux (pression sur le profil), facteurs de
    charge (manœuvre, rafale), flexion et torsion de l'aile, voilement de la peau,
    point neutre et marge statique, braquage d'équilibre, couple des servos, poutres,
    vibrations, atterrissage dur -> docs/essais_virtuels*.md + graphiques
    - DFR : longeron principal 16 mm (le 12 mm dépassait sa résistance à la charge extrême)
    - Ailes : plus d'âmes près de l'emplanture (DFR 20/14/10/6, Mini 12/8/5) : la peau
    n'ondule plus avant la charge limite
    - README : trous de palonnier et débattements ±20°, chiffres de masse et d'aut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
    [1_jauge_tubes.stl, 2_tranche_aile.stl, 3_jonction_cote_milieu.stl, aile_segment_1_droit.step, aile_segment_1_droit.stl, aile_segment_1_gauche.step, aile_segment_1_gauche.stl, aile_segment_2_droit.step]
2026-10-05 Vols simulés dans ArduPilot (SITL) et paramètres corrigés
    - simulation/modele_sitl.py : modèle de vol calculé à partir des cotes (masse, inerties,
    aérodynamique, stabilité, poussée VTOL selon la tension, hélice propulsive, batterie)
    - simulation/vol_simule.py : 5 scénarios dans ArduPlane 4.7.1 (mission, vent, rafales
    fortes, perte radio, batterie presque vide) -> docs/simulation*.md + graphiques
    - simulation/sitl_poussee.patch : propulseur réaliste dans le simulateur
    - Paramètres : noms ArduPlane 4.7 (ARMING_SKIPCHK, Q_A_ANGLE_MAX), Q_ASSIST_ALT 20,
    BATT_FS_VOLTSRC 1, Mini Q_ASSIST_SPEED 12 / AIRSPEED_MIN 14 / TRIM_THROTTLE 55,
    gaz de stationnaire réalistes, DFR réserv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
    [huard_dfr.param, huard_mini.param]
2026-10-05 Notice : collage des pylônes pas à pas, avec vues éclatées
    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
2026-10-05 Pylônes vissés : 2 vis M3 fraisées dans des inserts laiton, piliers dans l'aile
    - Aile : 2 piliers pleins en losange (voiles à 45° pour l'impression), perçage Ø3,4 et
    fraisage pour tête M3 au droit de chaque pylône
    - Pylône : 2 perçages pour inserts laiton M3 courts (Ø4 x 5), au-dessus de la poutre
    - Notice, nomenclatures (inserts courts, vis fraisées), vue éclatée ; vérifications OK
    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
    [2_tranche_aile.stl, aile_segment_1_droit.step, aile_segment_1_droit.stl, aile_segment_1_gauche.step, aile_segment_1_gauche.stl, aile_segment_2_droit.step, aile_segment_2_droit.stl, aile_segment_2_gauche.step]
2026-10-05 Câblage des moteurs VTOL : chemin des fils, tunnels agrandis
    - Le faisceau prévu remplissait le tunnel de l'aile du Mini à 81 % : impossible à tirer
    - Une paire d'alimentation par côté (Y vers les 2 ESC dans la poutre), signaux des 2 ESC
    dans une rallonge de servo ; tunnels Ø9 (Mini) et Ø10 (DFR) : remplissage ~37 %
    - Notice : moteur -> ESC par l'extérieur, trous des ESC, faisceau, connecteurs balles au
    fuselage (passent dans le tunnel), démontage d'un bloc poutre ; nomenclatures
    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
    [2_tranche_aile.stl, aile_segment_1_droit.step, aile_segment_1_droit.stl, aile_segment_1_gauche.step, aile_segment_1_gauche.stl, aile_segment_2_droit.step, aile_segment_2_droit.stl, aile_segment_2_gauche.step]
2026-10-05 Notice : branchement de la batterie et distribution de puissance
    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
2026-10-05 Mini : nez sans trou de Pitot (pas de capteur de vitesse)
    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
    [aile_segment_1_droit.step, aile_segment_1_gauche.step, aile_segment_2_droit.step, aile_segment_2_gauche.step, aile_segment_3_droit.step, aile_segment_3_gauche.step, aileron_1_droit.step, aileron_1_gauche.step]
2026-10-05 Notice : pose du GPS et précautions pour la boussole
    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
2026-10-05 GPS vissé : berceau PETG sous la trappe, 2 plots et 2 vis M2
    - support_gps : cuvette aux cotes du GPS (Mini MicoAir 20x20x8, DFR Holybro 34x28x11),
    rebord, fenêtre et encoche pour le fil, 2 oreilles vissées
    - trappe : 2 plots avec avant-trous sous la peau ; vérification avec le GPS dans le berceau
    - notice, impression, nomenclatures, vue éclatée de dessous
    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
    [aile_segment_1_droit.step, aile_segment_1_gauche.step, aile_segment_2_droit.step, aile_segment_2_gauche.step, aile_segment_3_droit.step, aile_segment_3_gauche.step, aile_segment_4_droit.step, aile_segment_4_gauche.step]
2026-10-05 Mini en PLA normal (empennage en PLA Aero) : masse, centrage, réglages revus
    - MATERIAU_LEGER / MATERIAU_EMPENNAGE : le Mini passe en PLA normal (+350 g, 2,21 kg) ;
    l'empennage reste en PLA Aero, sinon 150 g de plomb dans le nez
    - Essais virtuels avec les propriétés du PLA : tout passe (peau plus rigide)
    - Vols simulés : décrochages répétés dans les rafales fortes -> AIRSPEED_MIN 15,
    Q_ASSIST_SPEED 13, AIRSPEED_CRUISE 20, TRIM_THROTTLE 62, AIRSPEED_MAX 25,
    Q_M_THST_HOVER 0,61 ; 5 scénarios propres
    - Bilan, notice, liste d'achats (filaments) mis à jour
    Claude-Session: https://claude.ai/code/session_01RLKEH34uiBSjns8giEMR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
    [aile_segment_1_droit.step, aile_segment_1_gauche.step, aile_segment_2_droit.step, aile_segment_2_gauche.step, aile_segment_3_droit.step, aile_segment_3_gauche.step, aileron_1_droit.step, aileron_1_gauche.step]
2026-10-05 Audit des STL par tranchage réel ; corrections issues de l'audit
    - audit_stl.py : maillage, pose au plateau et tranchage PrusaSlicer de chaque STL,
    dépôt comparé couche par couche aux parois du modèle
    - voiles du pylône et du fuselage qui fusionnent franchement (maillages étanches)
    - fuselage réglé à 2 parois dans la notice
    - trous des inserts du pylône : 6 mm devant ; vis arrière M3 x 14 (Mini) / x 18 (DFR)
    - avant-trous traversants des vis de coin de la platine moteur
    - rebord du berceau GPS en pente (s'imprime sans pendre)
    - notice : ordre d'enfilage sur la poutre, position des pattes, réglages du kit d'essai
    Claude-S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
    [3_jonction_cote_milieu.stl, 4_platine_moteur.stl, aile_segment_1_droit.step, aile_segment_1_droit.stl, aile_segment_1_gauche.step, aile_segment_1_gauche.stl, aile_segment_2_droit.step, aile_segment_2_droit.stl]
